ozgurselenozge/EE463-Hardware-Project/README.md

# EE463-Hardware-Project
EE463 Hardware Project: AC-DC converter
