ozgurselenozge/EE463-Hardware-Project/Term Project/463 Project Presentation.pptx

## SoC

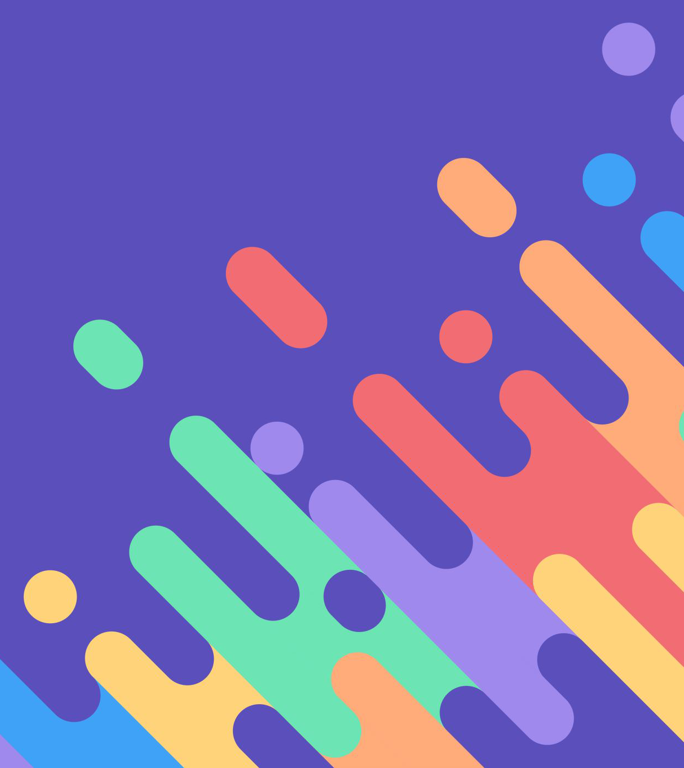
[picture p17: figure]
Vector background of vibrant colours splashing

Selen Özge Özgür
Canberk Kaçan
Onat Şimşek

## Slide 2

Design Topology

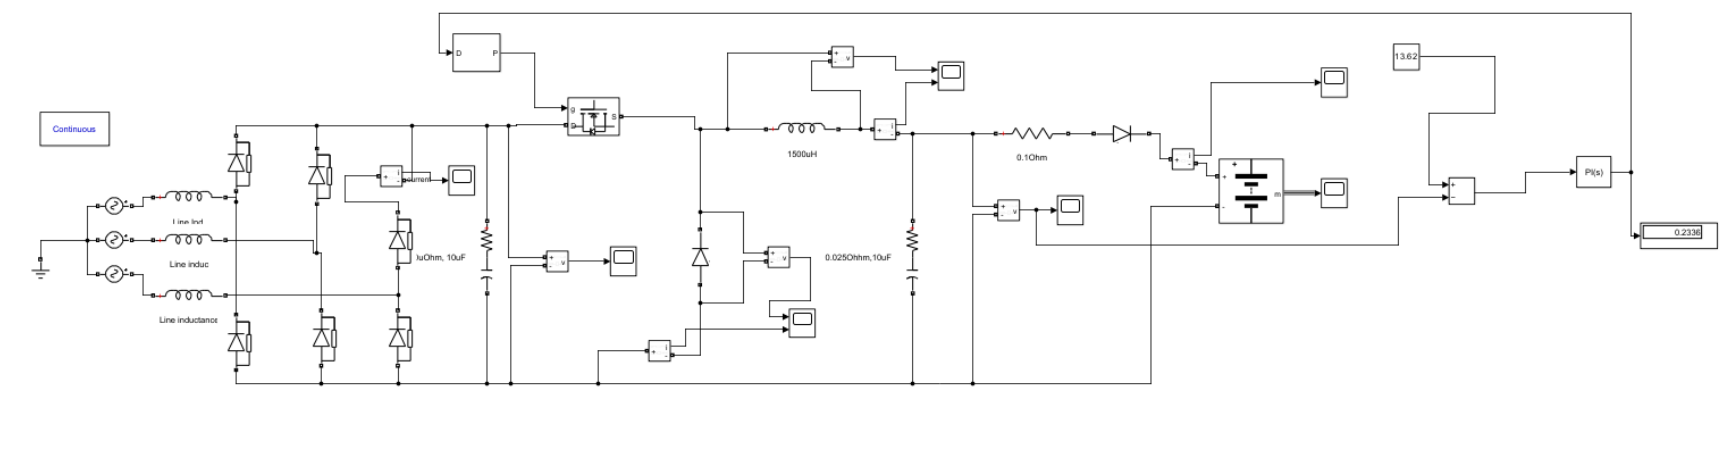
[picture p18: figure]

## Theoretical Calculations

| Theoretical Calculation | Simulation Results
Buck Converter Inductance (L) | 80. 64 µH (min) | 1500 µH
Buck Converter Capacitance | 0.83 µF | 10 µF
Three Phase FBDR Capacitance | 8.95 µF | 10 µF

## Three Phase FBDR Simulation Results

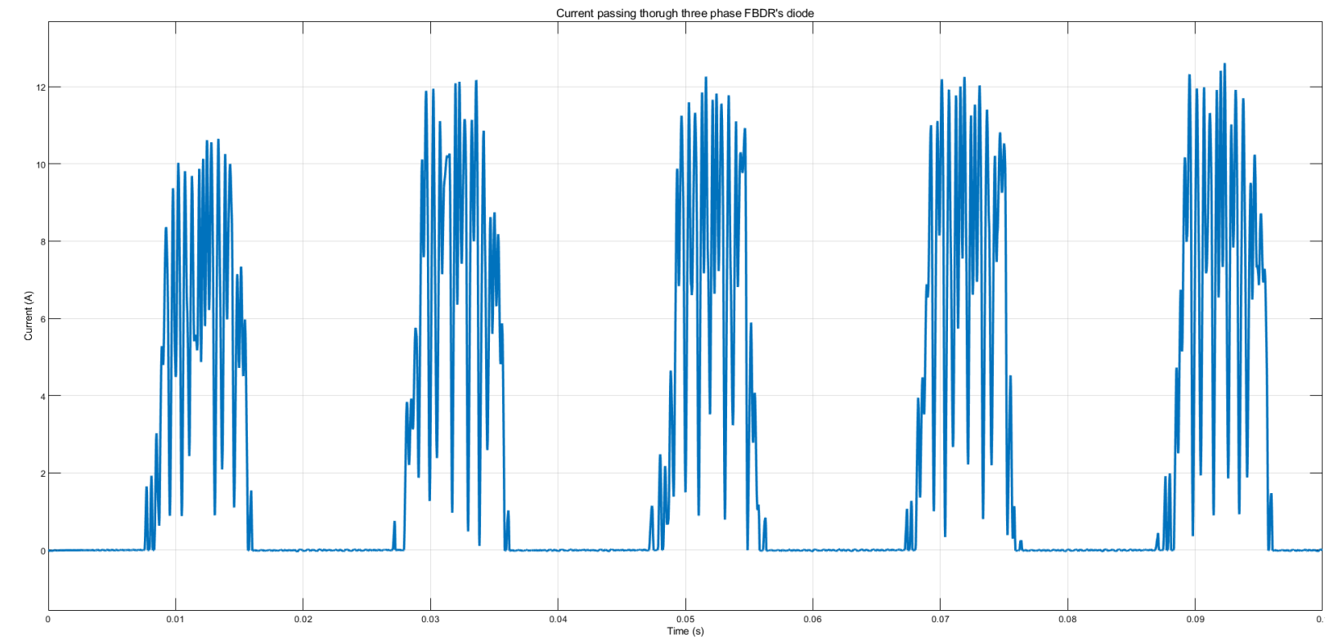
[picture p19: figure]
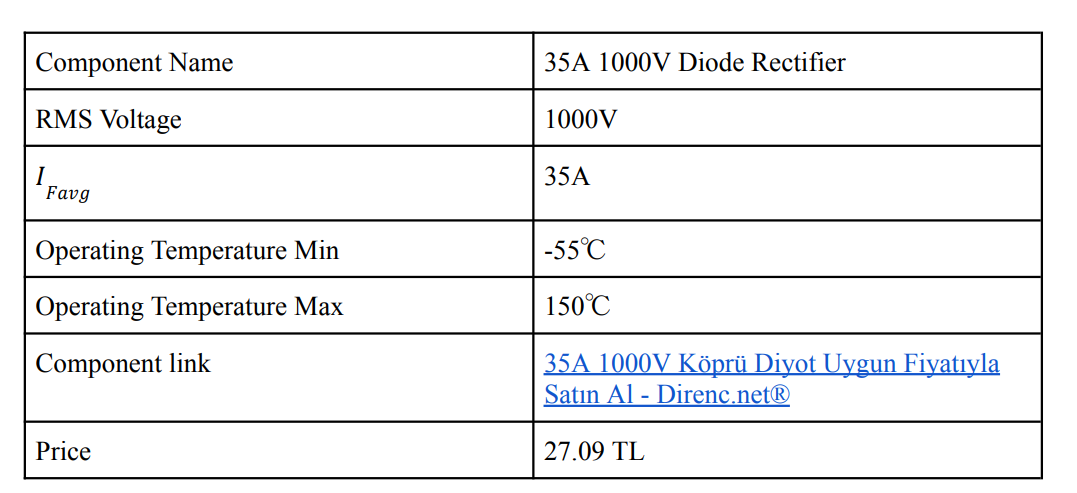
[picture p20: figure]

35A 1000V (https://www.direnc.net/35a-1000v-kopru-diyot)Köprü (https://www.direnc.net/35a-1000v-kopru-diyot) (https://www.direnc.net/35a-1000v-kopru-diyot)Diyot (https://www.direnc.net/35a-1000v-kopru-diyot) Uygun (https://www.direnc.net/35a-1000v-kopru-diyot)Fiyatıyla (https://www.direnc.net/35a-1000v-kopru-diyot) (https://www.direnc.net/35a-1000v-kopru-diyot)Satın (https://www.direnc.net/35a-1000v-kopru-diyot) Al - Direnc.net® (https://www.direnc.net/35a-1000v-kopru-diyot)

Current wavefroms of the three phase FBDR. Maximum current of the rectifier is 12 A.

## Three Phase FBDR Simulation Results

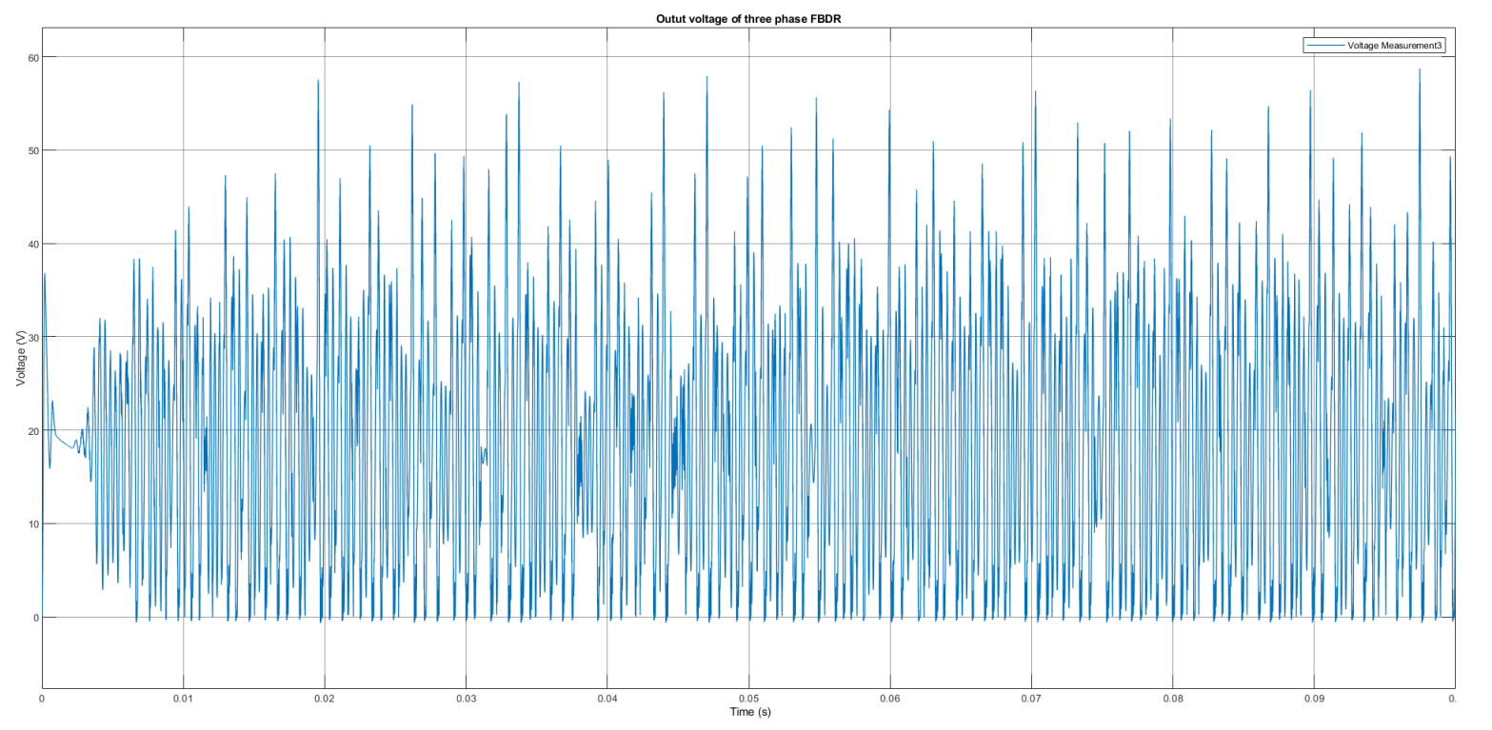
[picture p21: figure]

Output Voltage wavefroms of the three phase FBDR given. Maximum voltage seen by Three phase FBDR is 60V.

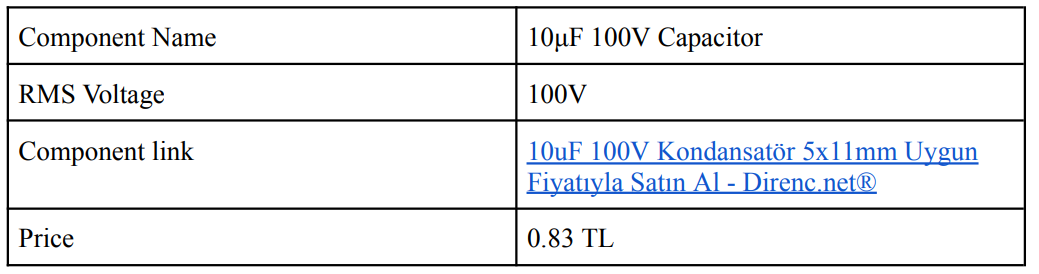
[picture p22: figure]

## Buck Converter Mosfet Waveforms

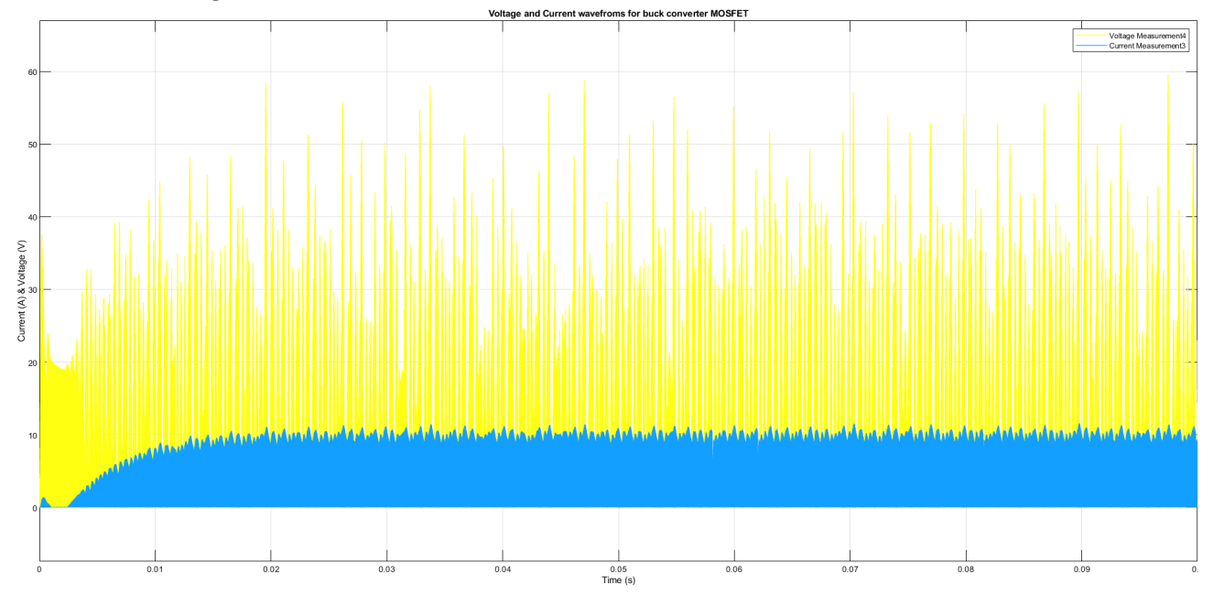
[picture p23: figure]
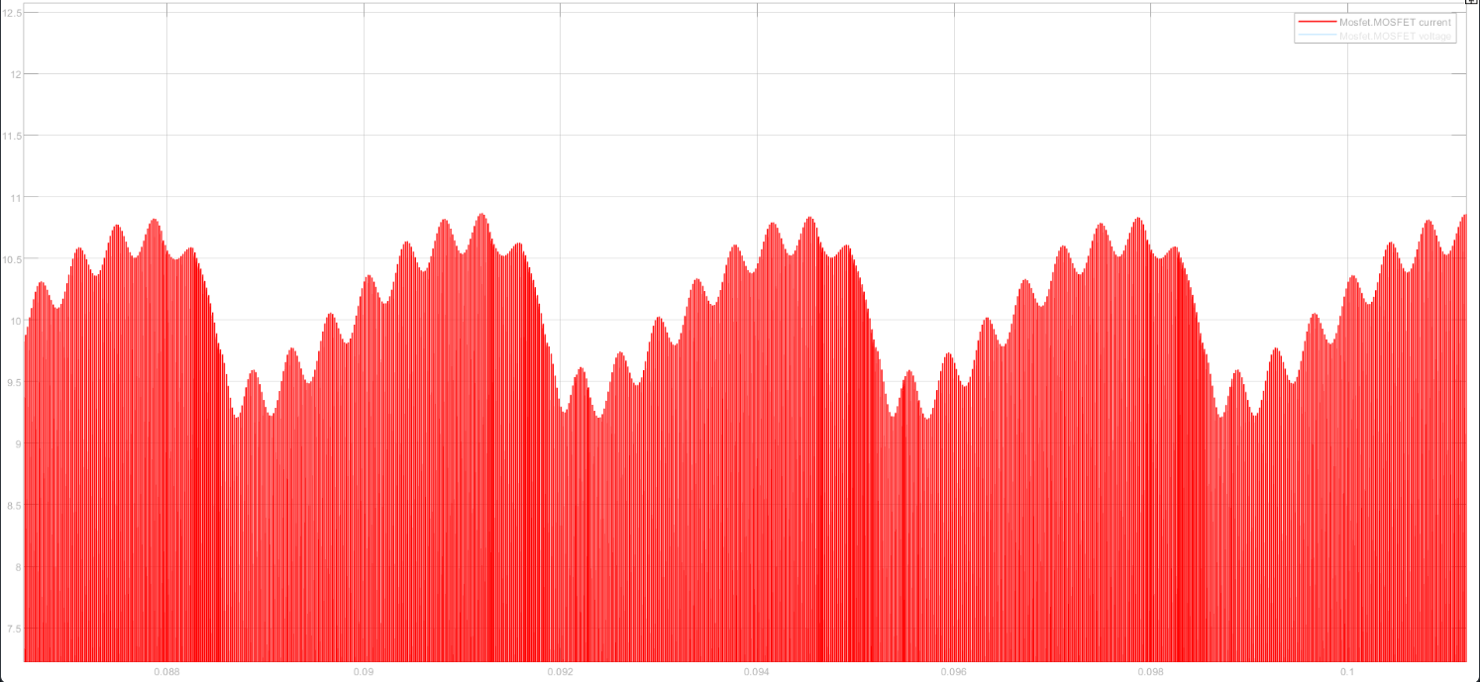
[picture p24: figure]

## Buck Converter Mosfet Waveforms

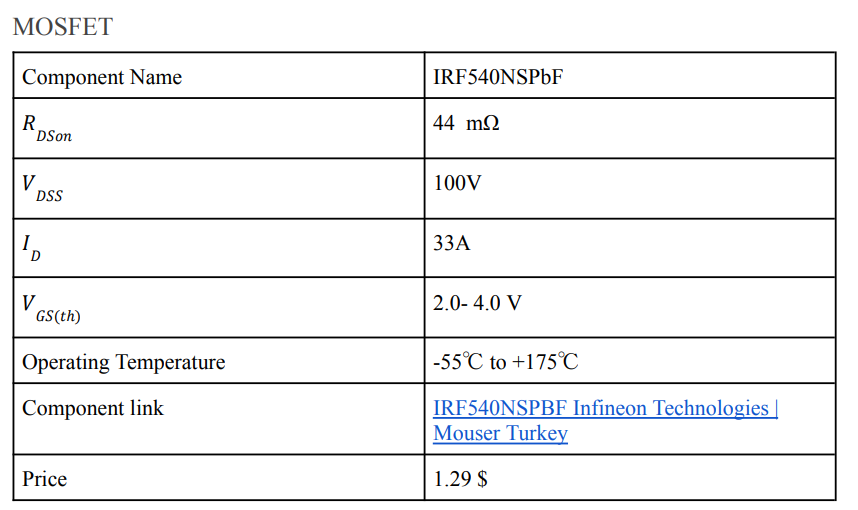
[picture p25: figure]

Buck Converter MOSFET peak current 11A, peak voltage less than 60V.

## Slide 8

Diode Waveform

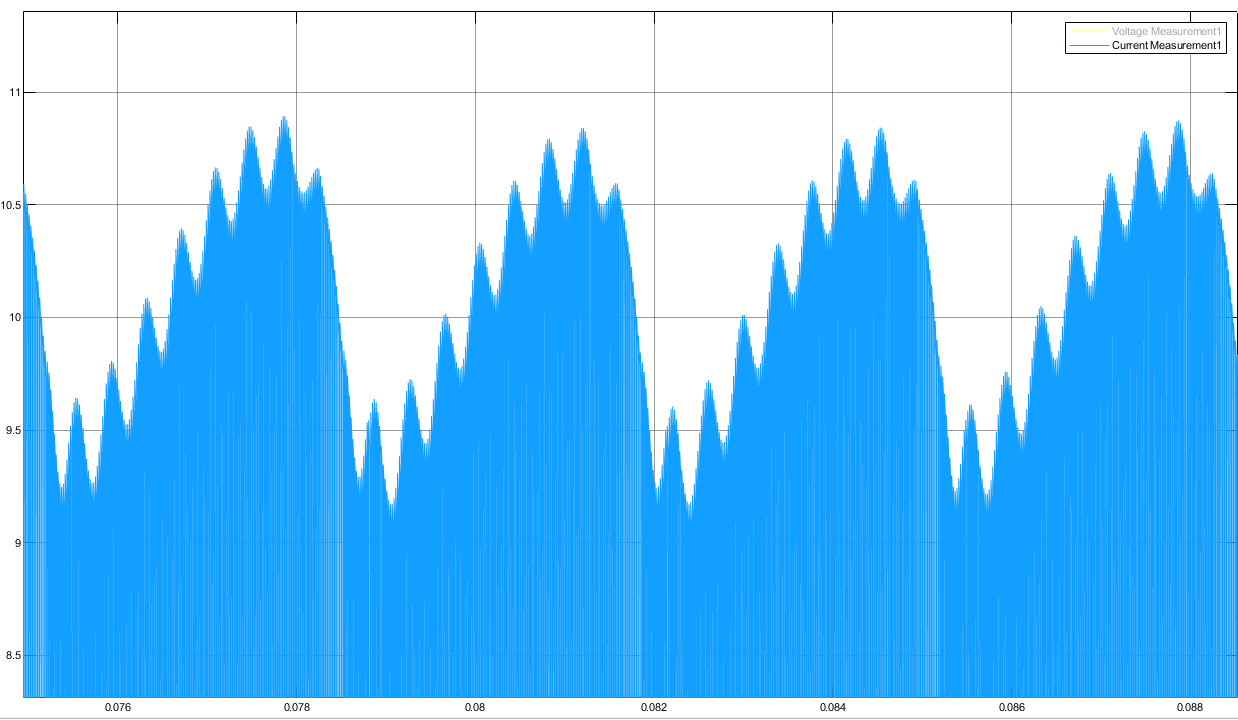
[picture p26: figure]

Peak = 11A

## Component Selection

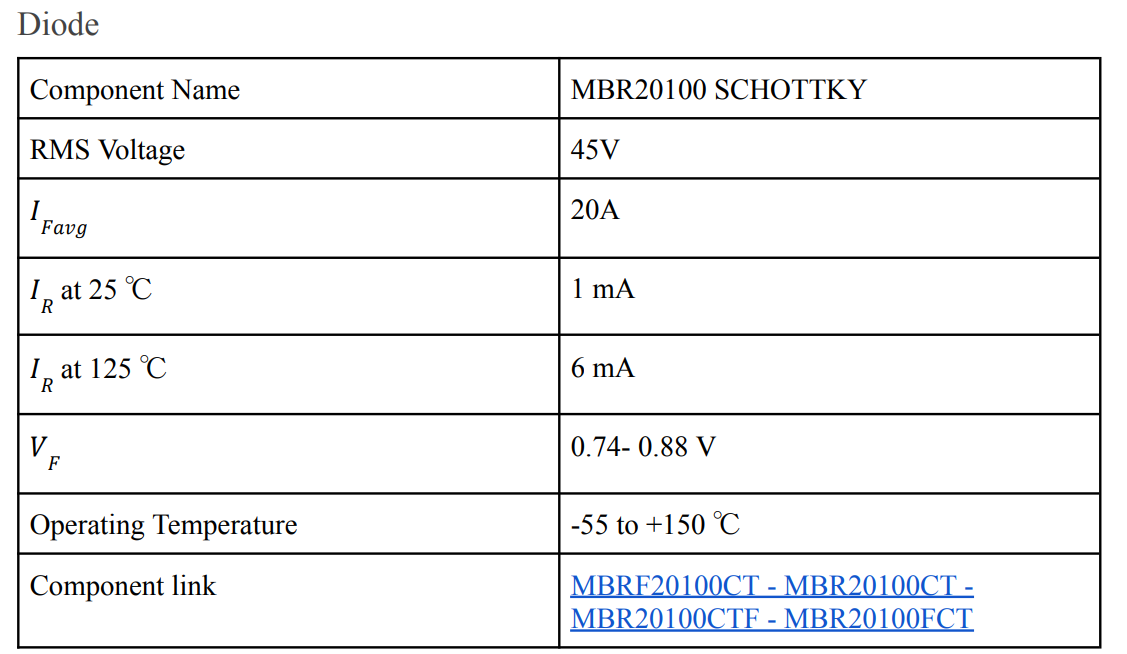
[picture p27: figure]

- Buck Converter diode peak current 11A, peak voltage less than 63.6V.

https://www.cakirelektronik.com/urun/mbr20100fct-mbr20100-20a-100v-schottky-barrier-rectifier

## Inductor Waveforms

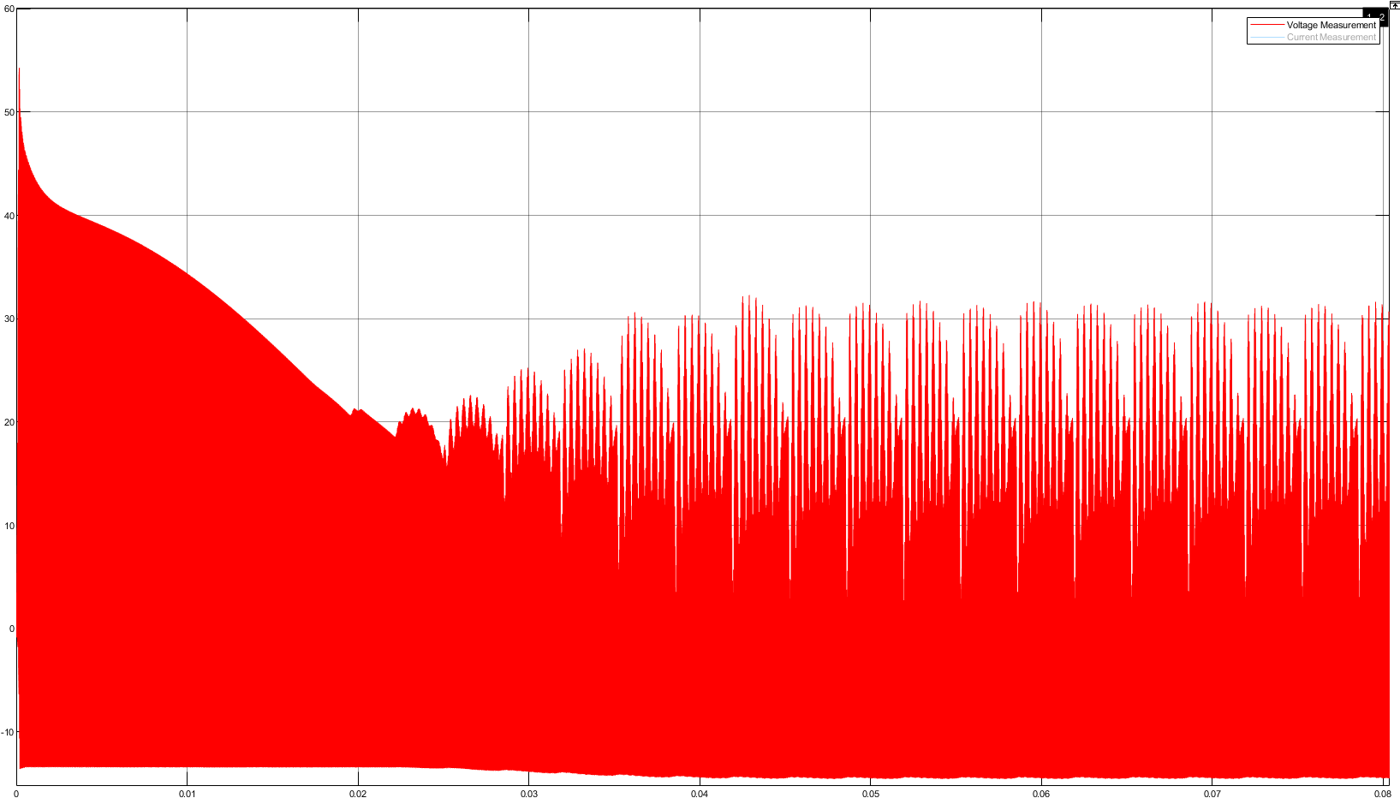
[picture p28: figure]
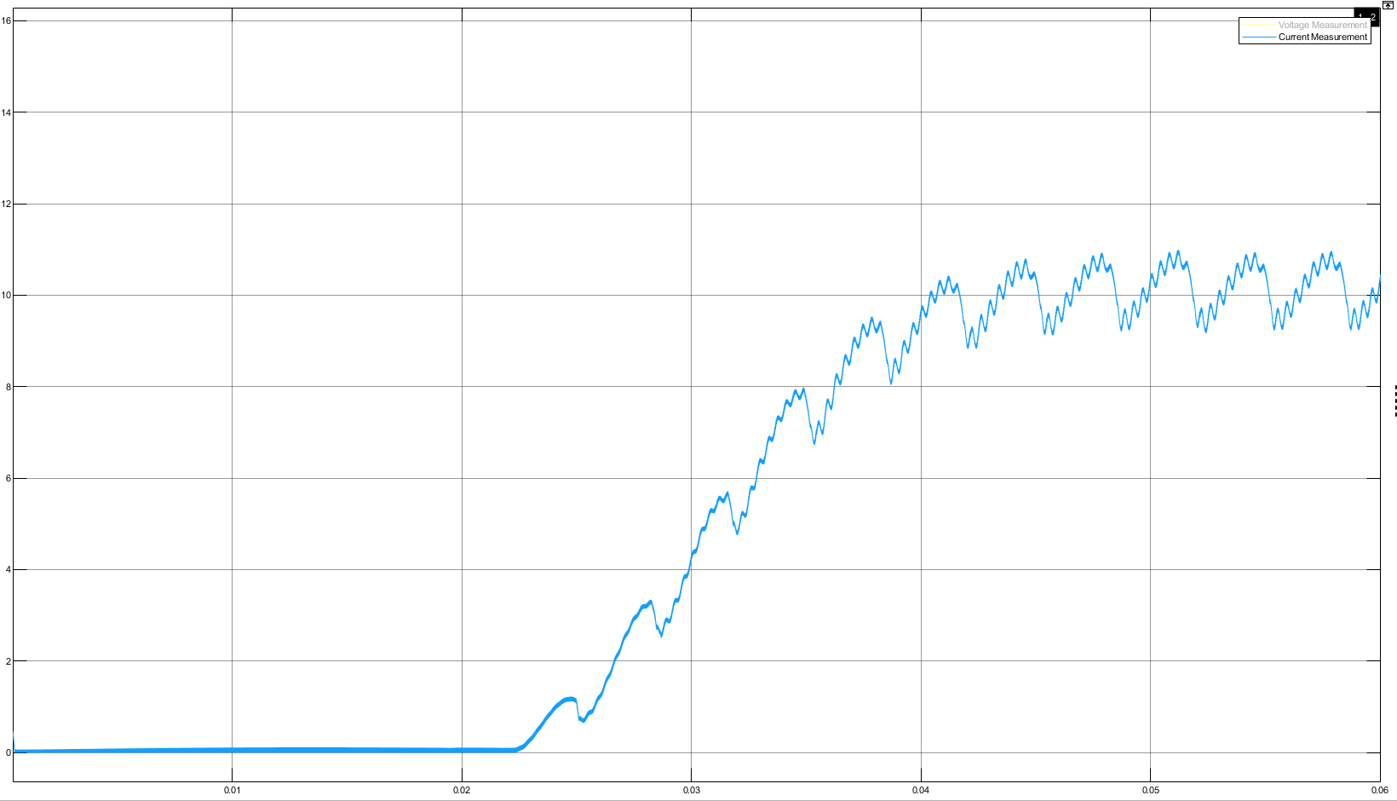
[picture p29: figure]

## Output Capacitor Waveform

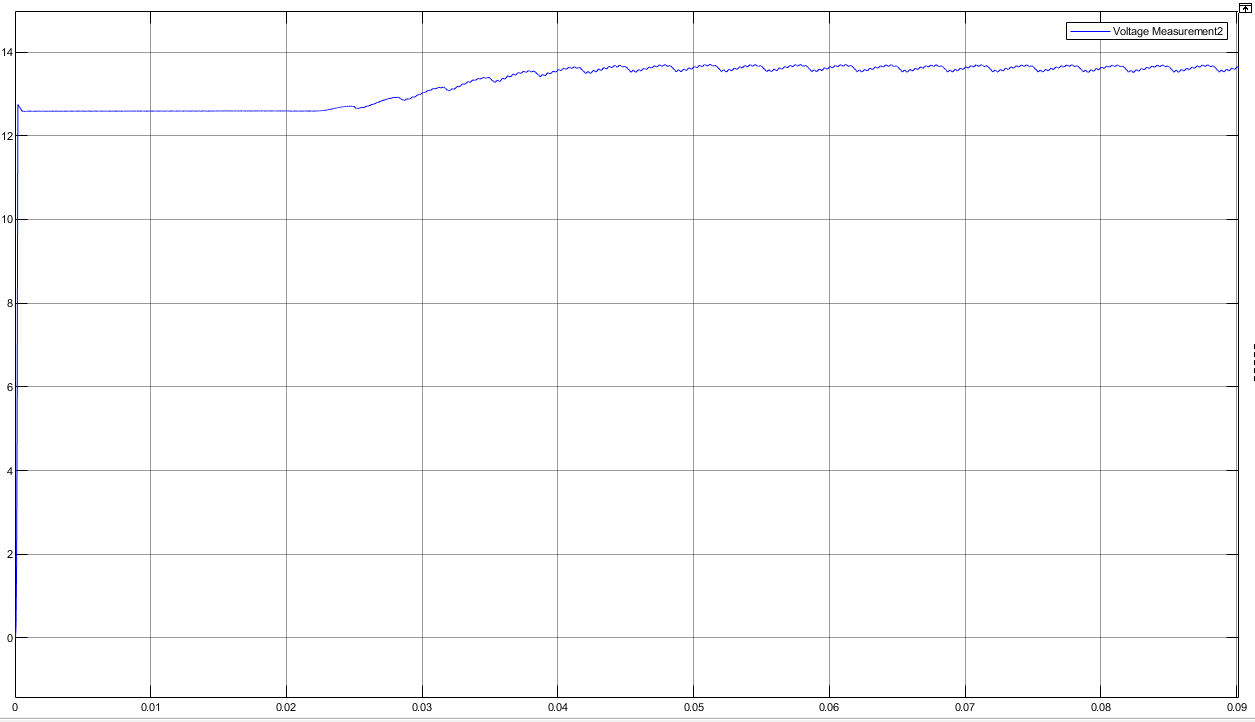
[picture p30: figure]

## Component Selection

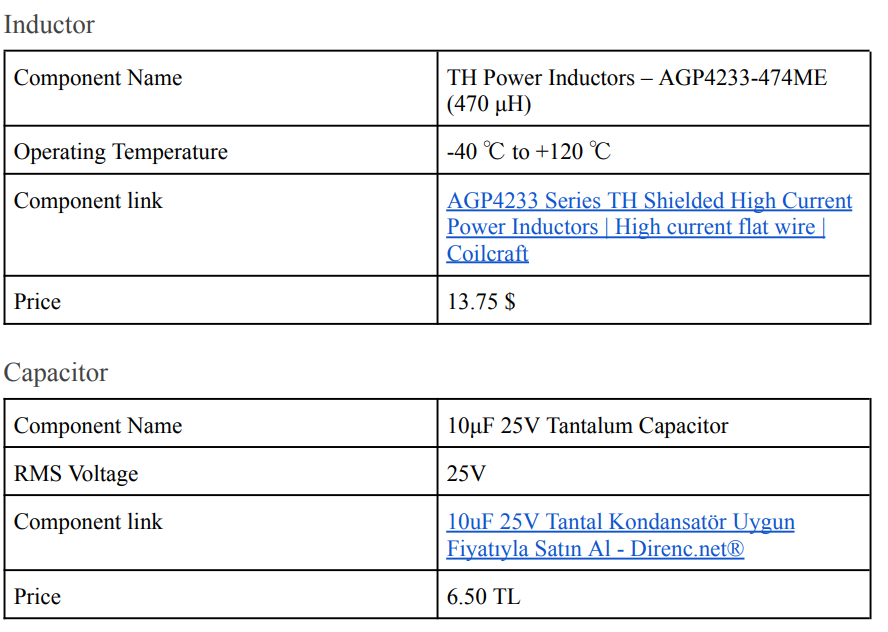
[picture p31: figure]

Buck Converter inductor peak current 11A, peak voltage less than 55V.

https://www.coilcraft.com/en-us/products/power/shielded-inductors/high-current-flat-wire/agp-ver/agp4233/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,low%20DC%20and%20AC%20resistance.

https://www.direnc.net/10uf25v-tantal

Buck Converter output capacitor peak voltage less than 13.7V.

## Slide 13

Component Selection

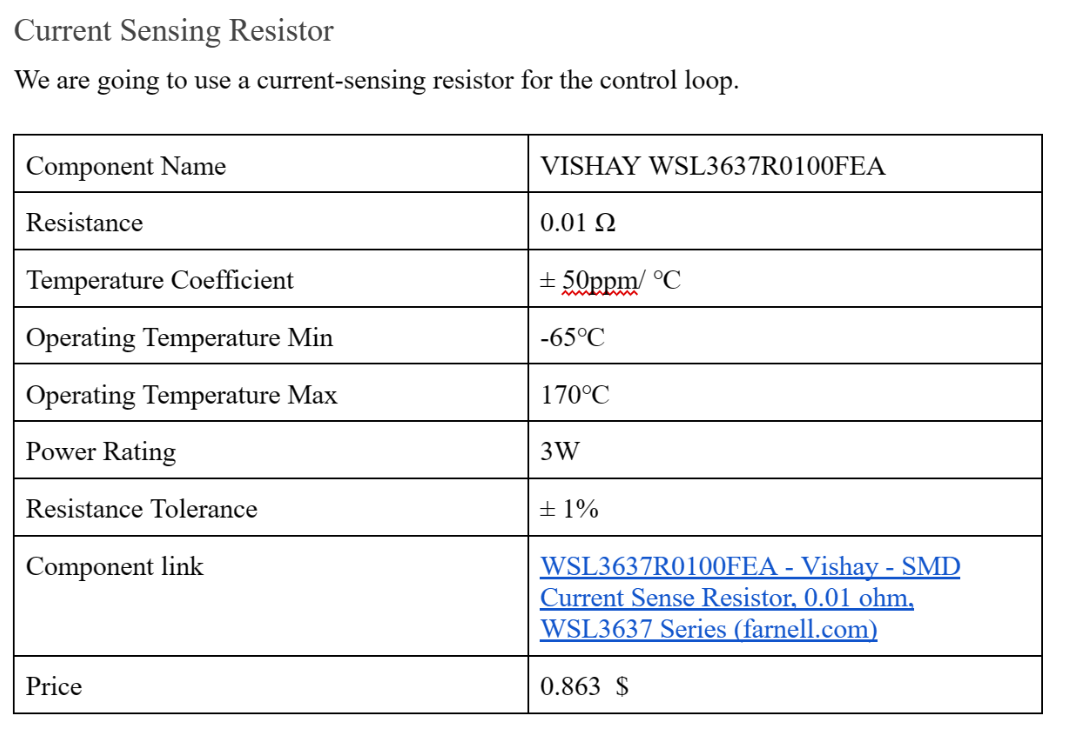
[picture p32: figure]

https://tr.farnell.com/vishay/wsl3637r0100fea/current-sense-res-0r01-1-3-w-3637/dp/2395994

## Diode, before the battery

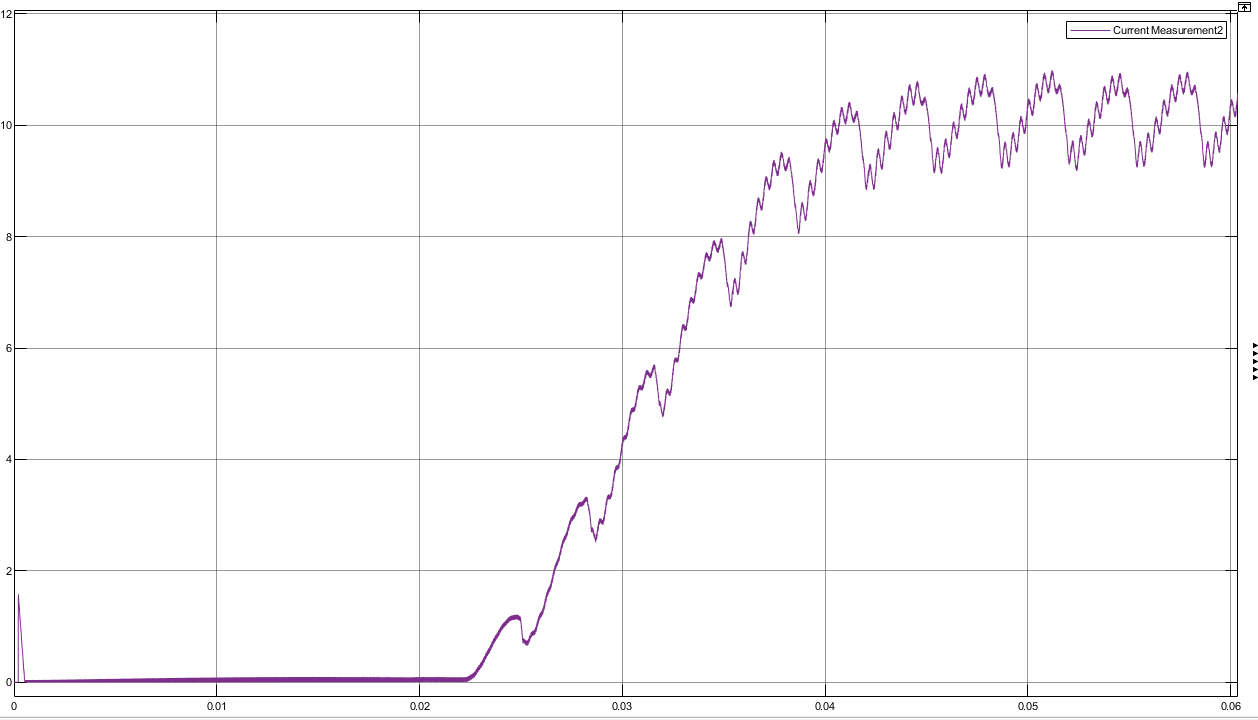
[picture p33: figure]

## Component Selection

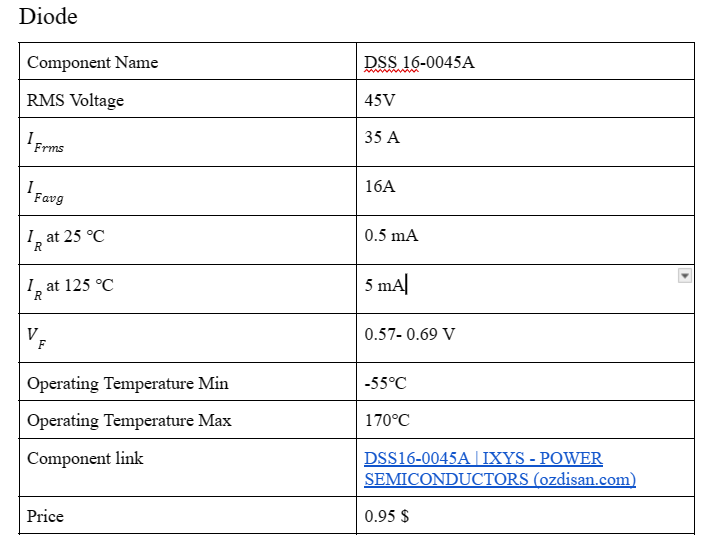
[picture p34: figure]

Buck Converter diode, before the battery, peak current 11A.

https://ozdisan.com/guc-yari-iletkenleri/diyotlar-modul-diyotlar-ve-dogrultucular/schottky-diyotlar/DSS16-0045A

## Controller Selection

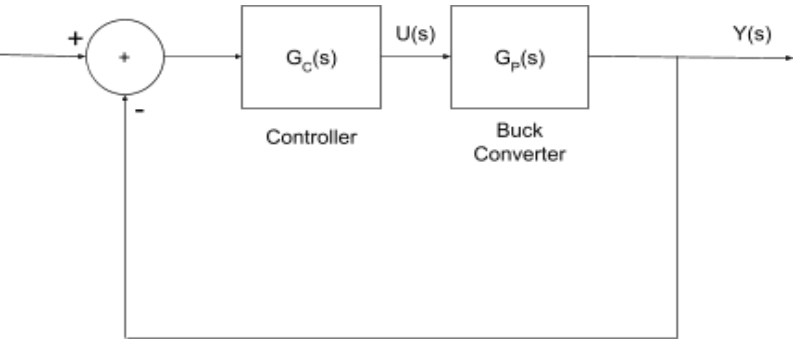
[picture p35: figure]
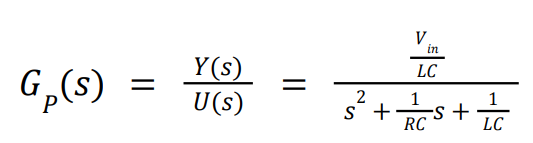
[picture p36: figure]

Transfer Function of the Buck converter is given above.
Y(s): Voltage output of the buck converter
U(s): Duty cycle

## Controller Selection

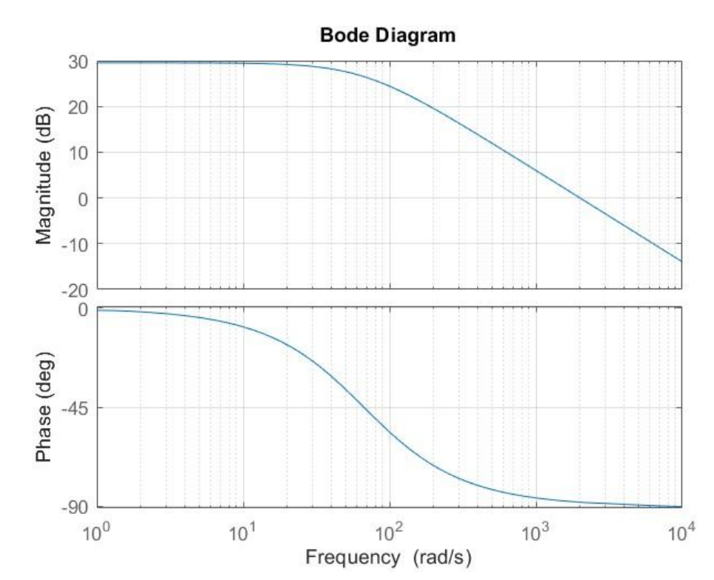
[picture p37: figure]

Bode Diagram of the open loop buck converter

By using PID tunning:
Kp = 0.068125711694835
Ki = 6.811891811116887

## Will be added

- Fuse (15A) after FBDR (before MOSFET) for currrent protection
- Analog or Digital Controller
- Over voltage protection (if we have time)
