ozgurselenozge/EE463-Hardware-Project/Term Project/3_phase_PWM_rectifier.pdf

# Three Phase Rectifier

## Vieri Xue

## C2000 System Application Engineer

# Content

## - Hardware Design Review

## - Software Design Review

## - Close-Loop Controller Review

# Introduction

## - Rectifier functions:

1. The AC to DC conversion.
2. Improve the power factor.
3. Reduce the THDi.

# Introduction

## - Three Phase PFC Topology - 6 Pulse + SCR + LC

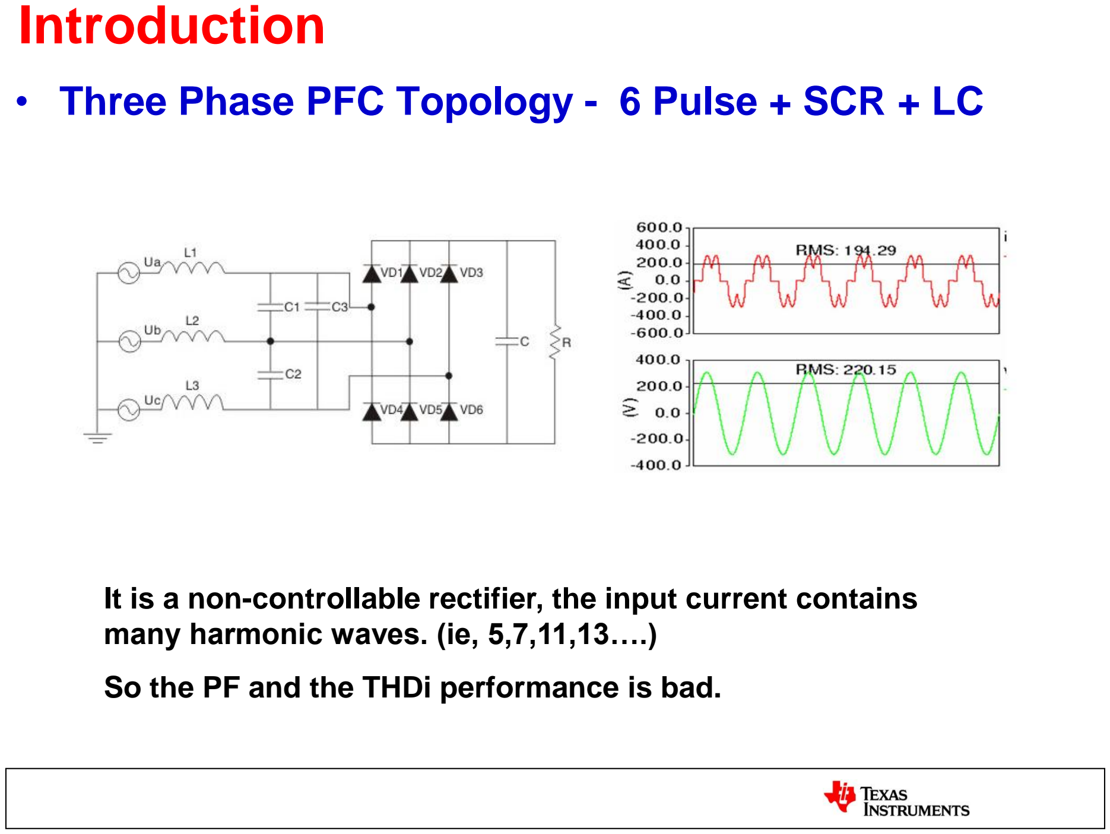
[picture p82: page 4]

It is a non-controllable rectifier, the input current contains many harmonic waves. (ie, 5,7,11,13….)

So the PF and the THDi performance is bad.

# Introduction

## - Three Phase PFC Topology - 12pulse + SCR + L

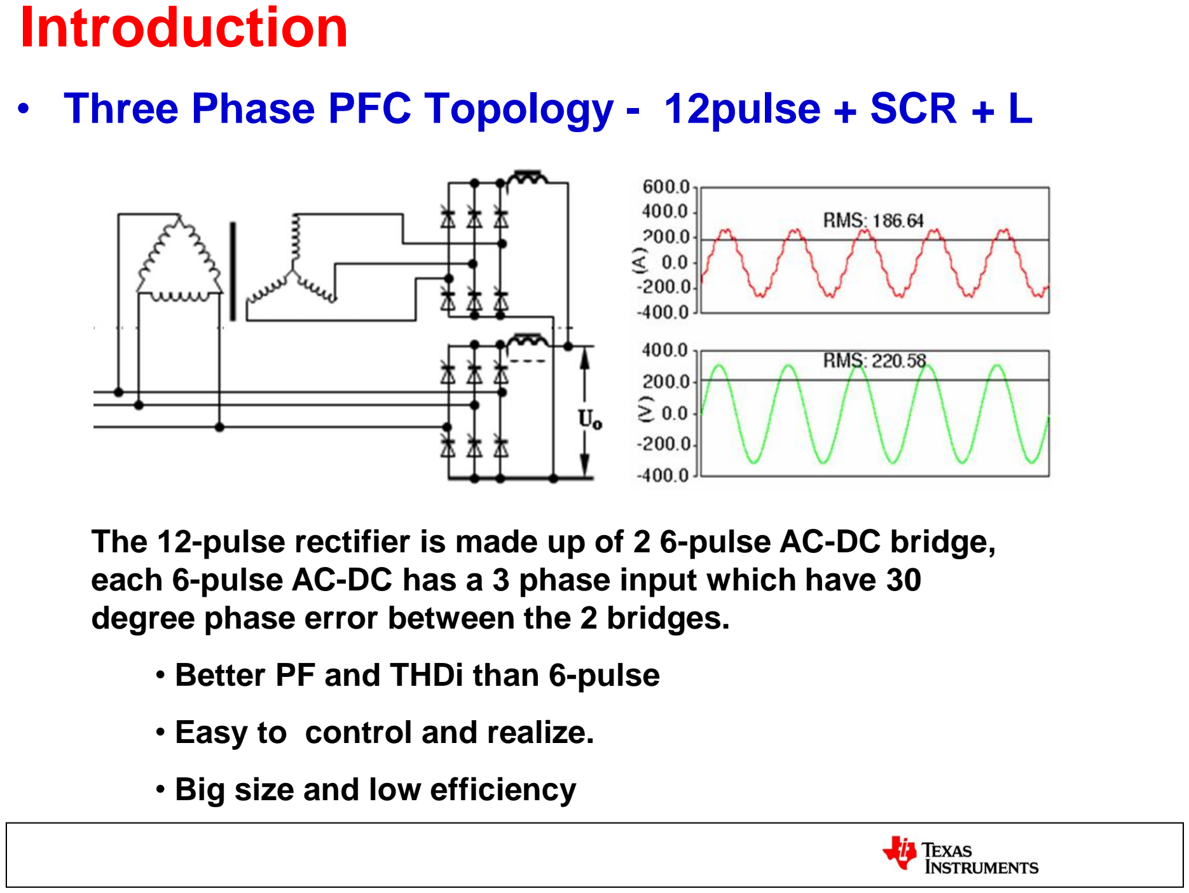
[picture p83: page 5]

The 12-pulse rectifier is made up of 2 6-pulse AC-DC bridge, each 6-pulse AC-DC has a 3 phase input which have 30 degree phase error between the 2 bridges.

- Better PF and THDi than 6-pulse
- Easy to control and realize.
- Big size and low efficiency

# Introduction

## - Three Phase PFC Topology - Vienna topology

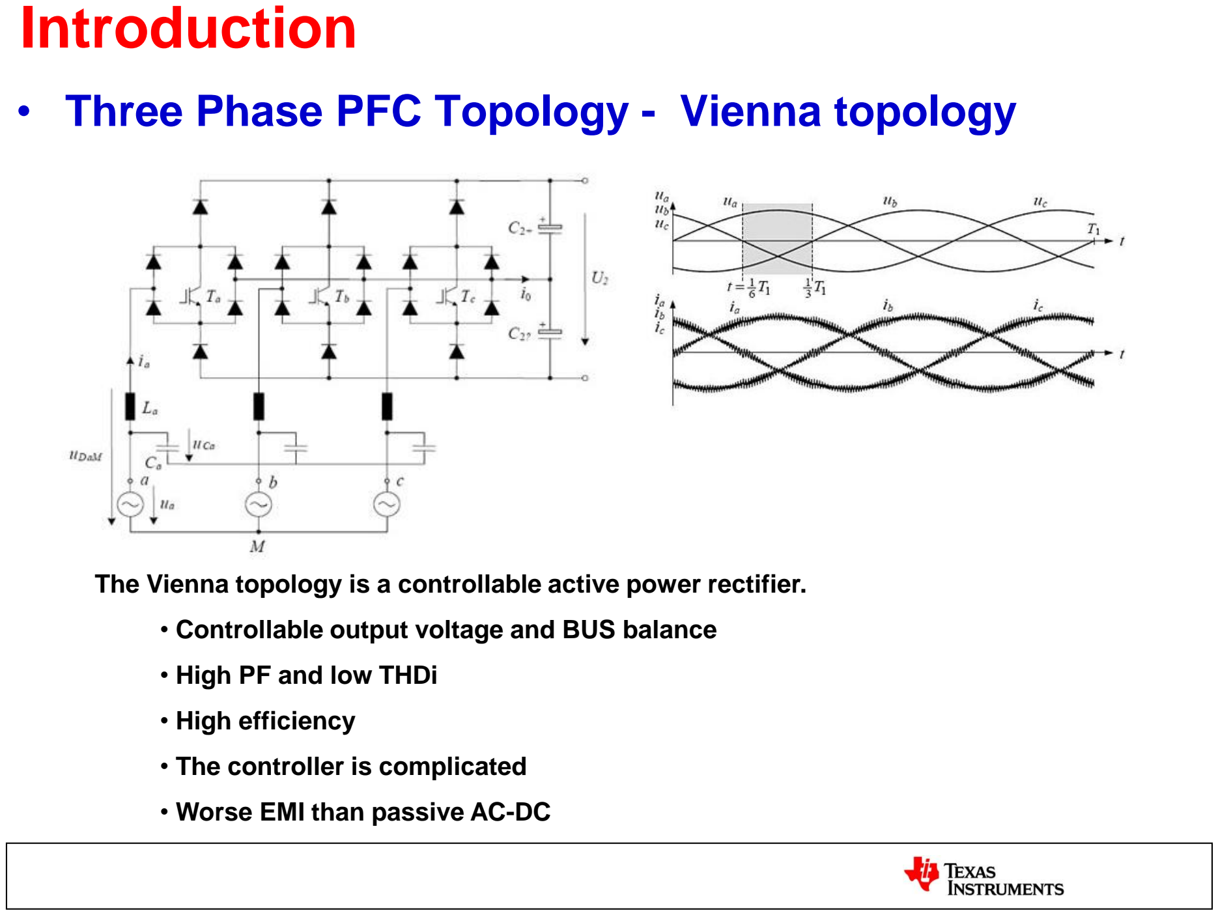
[picture p84: page 6]

The Vienna topology is a controllable active power rectifier.

- Controllable output voltage and BUS balance
- High PF and low THDi
- High efficiency
- The controller is complicated
- Worse EMI than passive AC-DC

# Introduction

## - Three Phase PFC Topology - 3 phase 2-level PWM

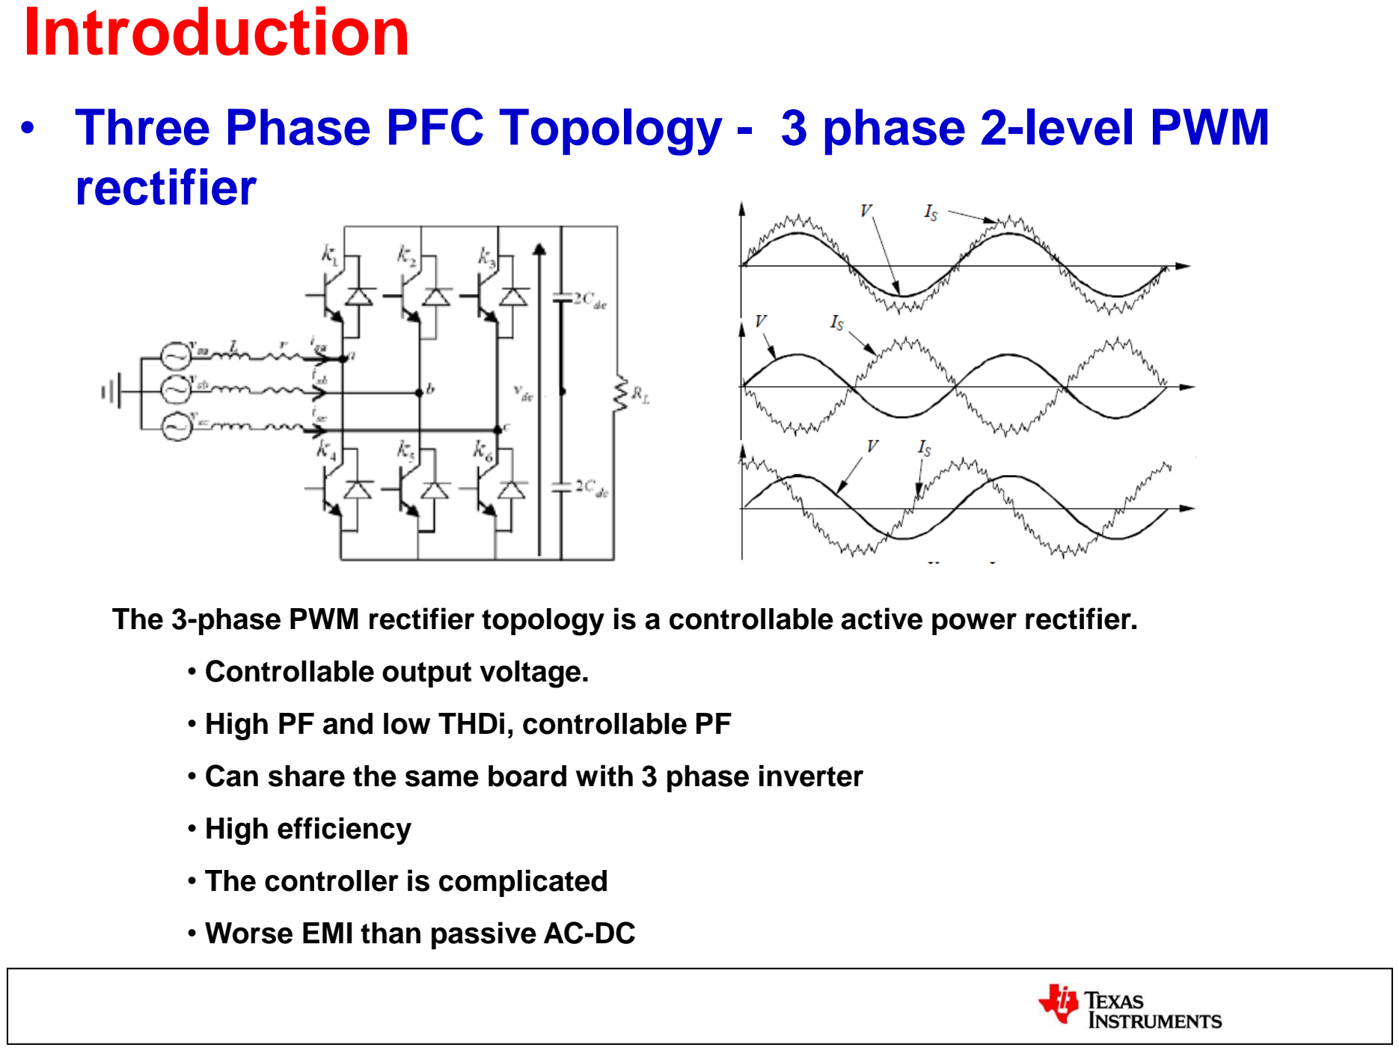
[picture p85: page 7]

## rectifier

The 3-phase PWM rectifier topology is a controllable active power rectifier.

- Controllable output voltage.
- High PF and low THDi, controllable PF
- Can share the same board with 3 phase inverter
- High efficiency
- The controller is complicated
- Worse EMI than passive AC-DC

# Introduction

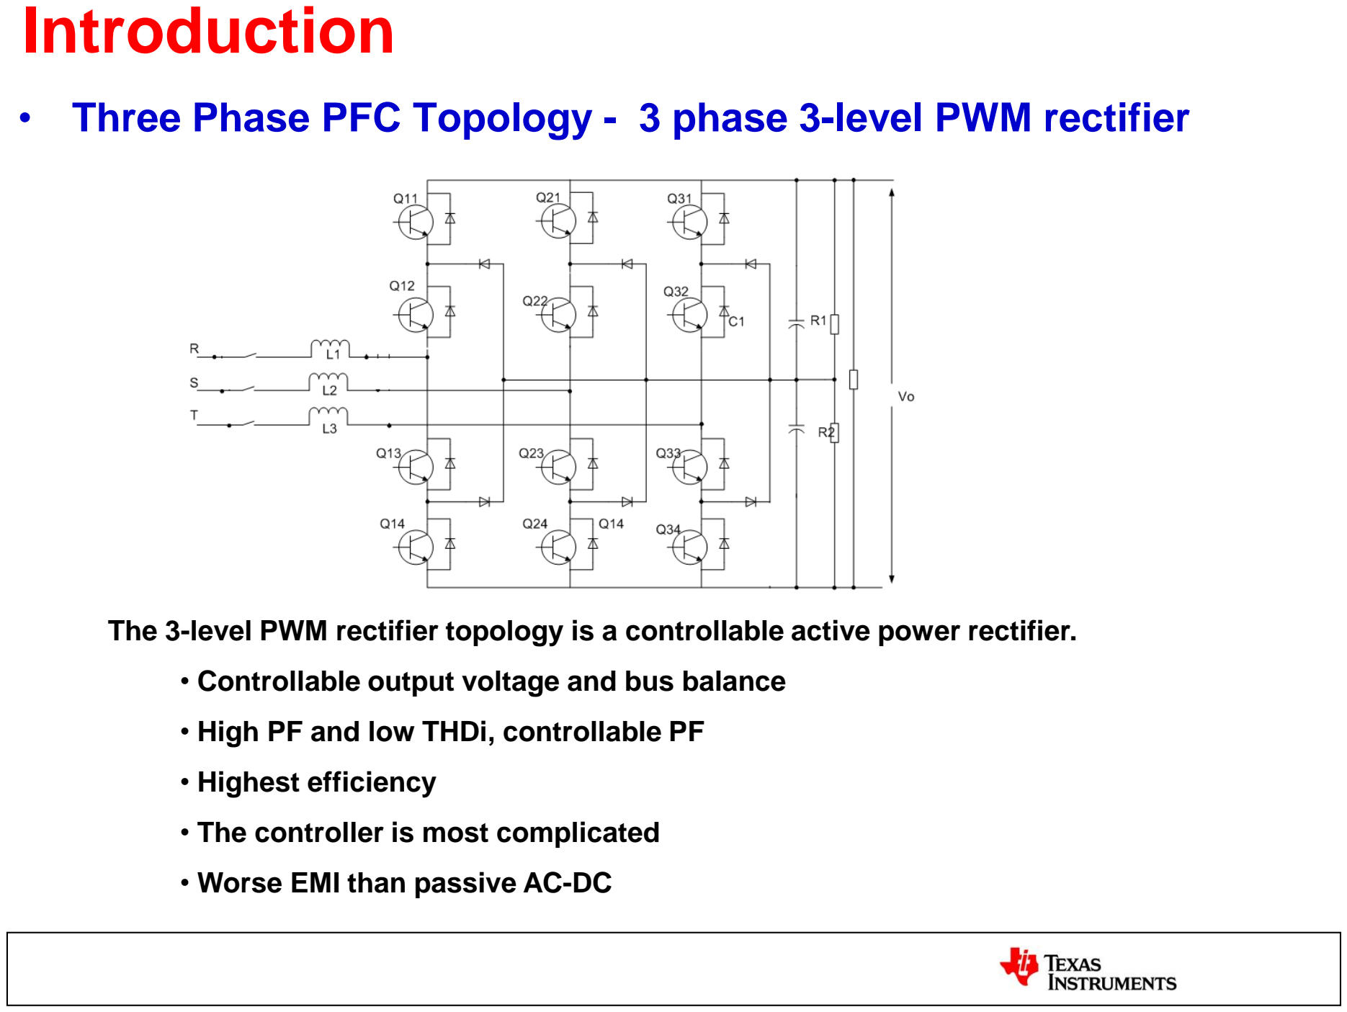
[picture p86: page 8]

- Three Phase PFC Topology - 3 phase 3-level PWM rectifier

The 3-level PWM rectifier topology is a controllable active power rectifier.

- Controllable output voltage and bus balance
- High PF and low THDi, controllable PF
- Highest efficiency
- The controller is most complicated
- Worse EMI than passive AC-DC

# Introduction

## - Application field

– | UPS
– | Telecommunication
– | Motor driver
– | Motor Energy Feedback Unit
– | Active Power Filter

# Introduction

## - 3-Phase 2-level PWM Rectifier principle

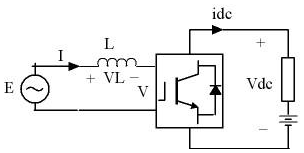
[picture p87: figure]
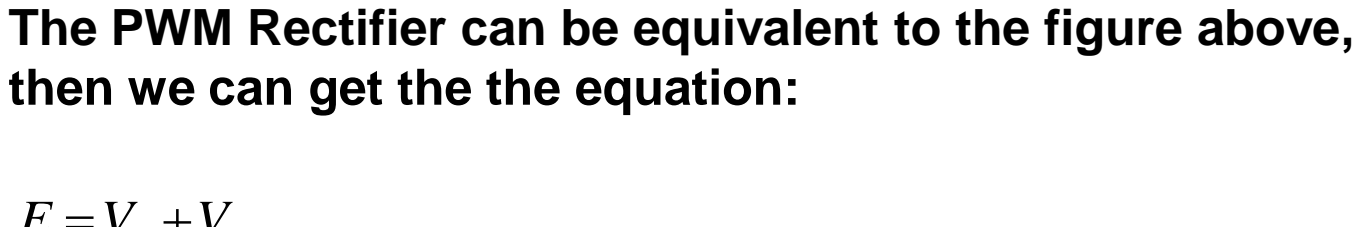
[picture p88: figure]
then we can get the the equation:

The PWM Rectifier can be equivalent to the figure above,

E V | V = | +L
ac ac | dc dc i v | i v =

# Introduction

## - Three Phase PWM Rectifier principle

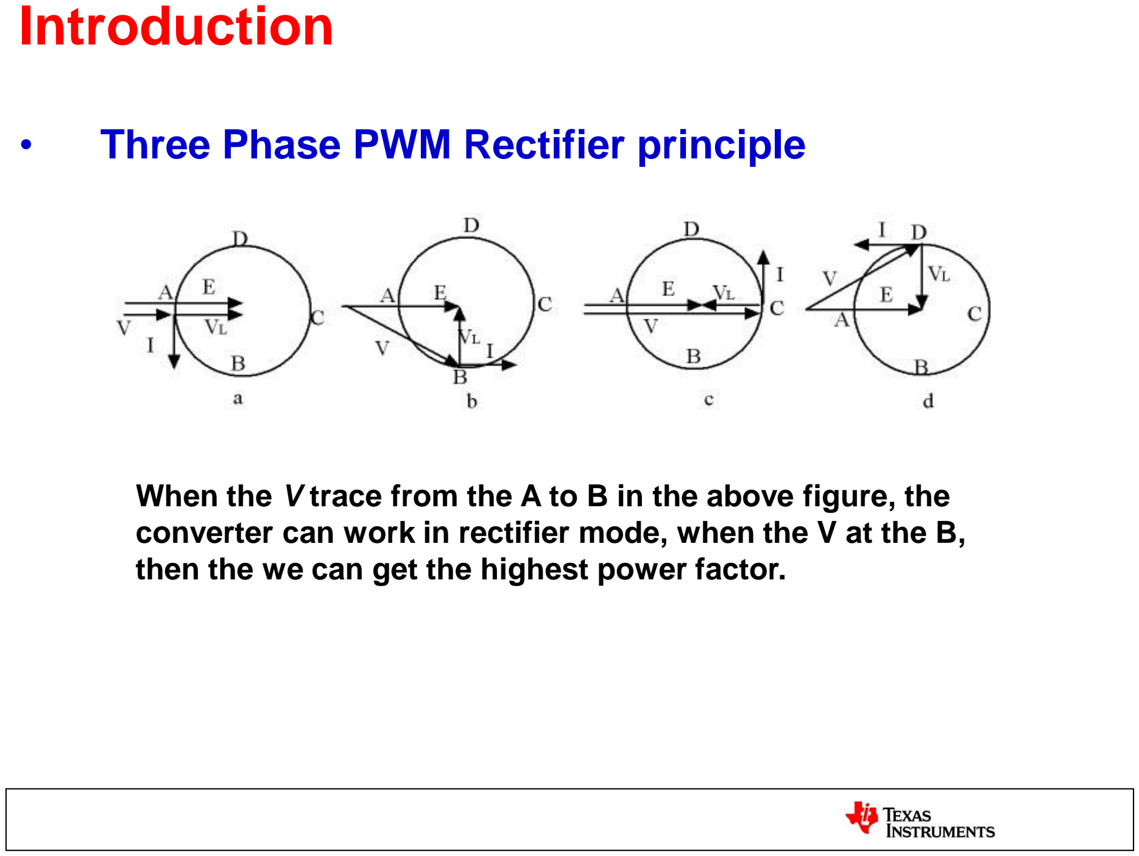
[picture p89: page 11]

When the V trace from the A to B in the above figure, the converter can work in rectifier mode, when the V at the B, then the we can get the highest power factor.

# Introduction

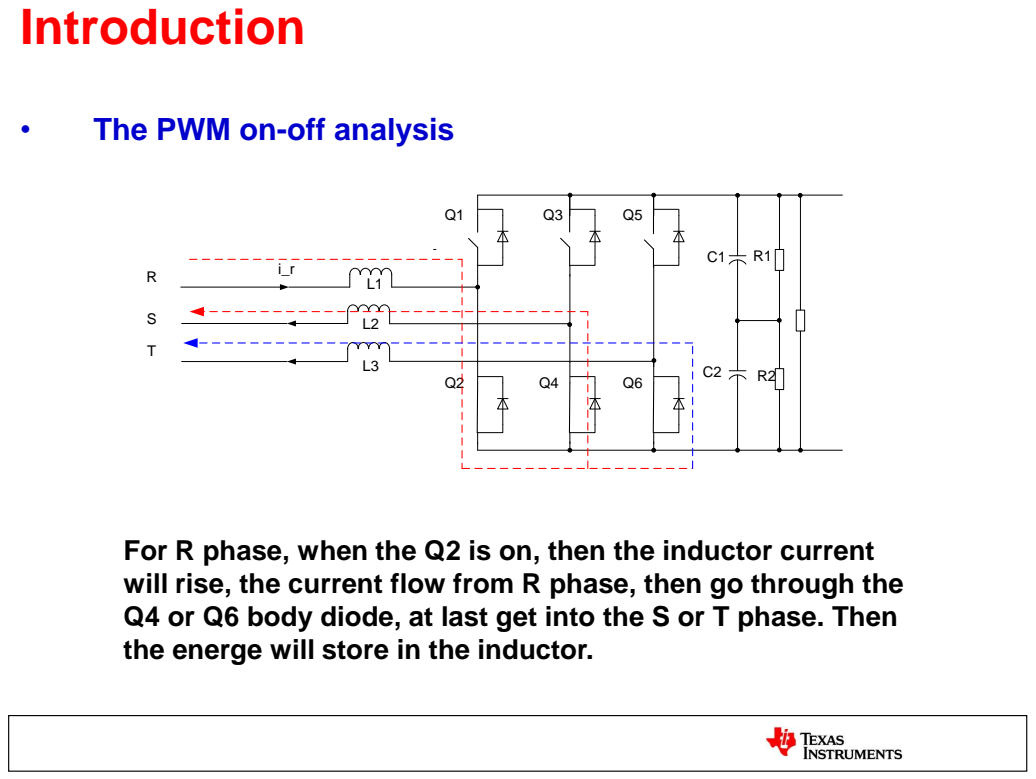
[picture p90: page 12]

• The PWM on-off analysis

For R phase, when the Q2 is on, then the inductor current
will rise, the current flow from R phase, then go through the
Q4 or Q6 body diode, at last get into the S or T phase. Then
the energe will store in the inductor.

# Introduction

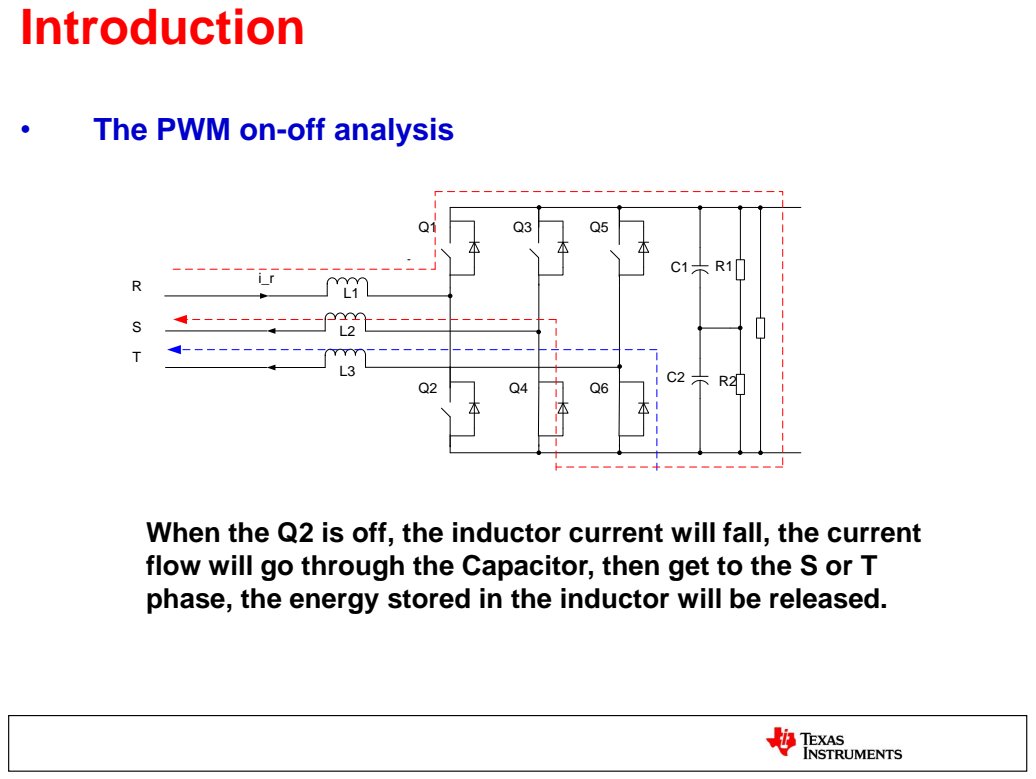
[picture p91: page 13]

• The PWM on-off analysis

When the Q2 is off, the inductor current will fall, the current
flow will go through the Capacitor, then get to the S or T
phase, the energy stored in the inductor will be released.

# Introduction

## - 3-phase PFC EVM basic specification

– | 3 phase 4 wire(or 3wire) input
– | 1200W @ 380VAC/50Hz
– | Output Voltage: 700VDC
– | Efficiency: >95%
– | THDi<5% @ Full load
– | Current unbalance ratio: <3%
– | Power Factor > 0.99 @ >50% Load
– | Piccolo B
– | GUI support

# Introduction

## - 3-phase PFC EVM Picture

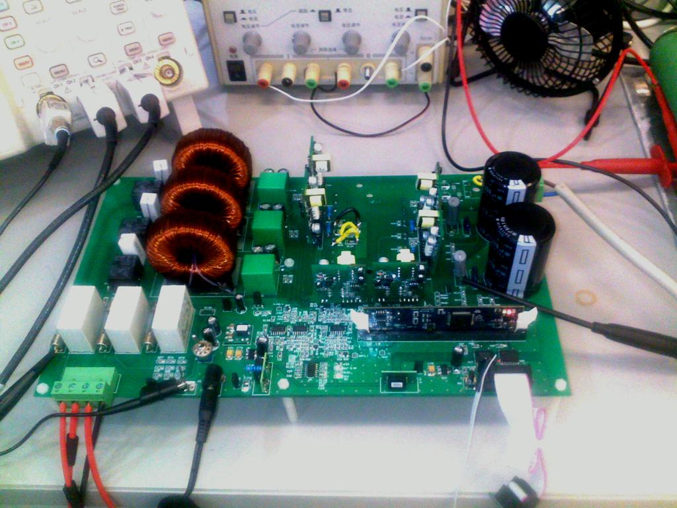
[picture p92: figure]

# Content

## - Introduction

## - Software Design Review

## - Close-Loop Controller Review

# Hardware Design Review

# - Main circuit topology

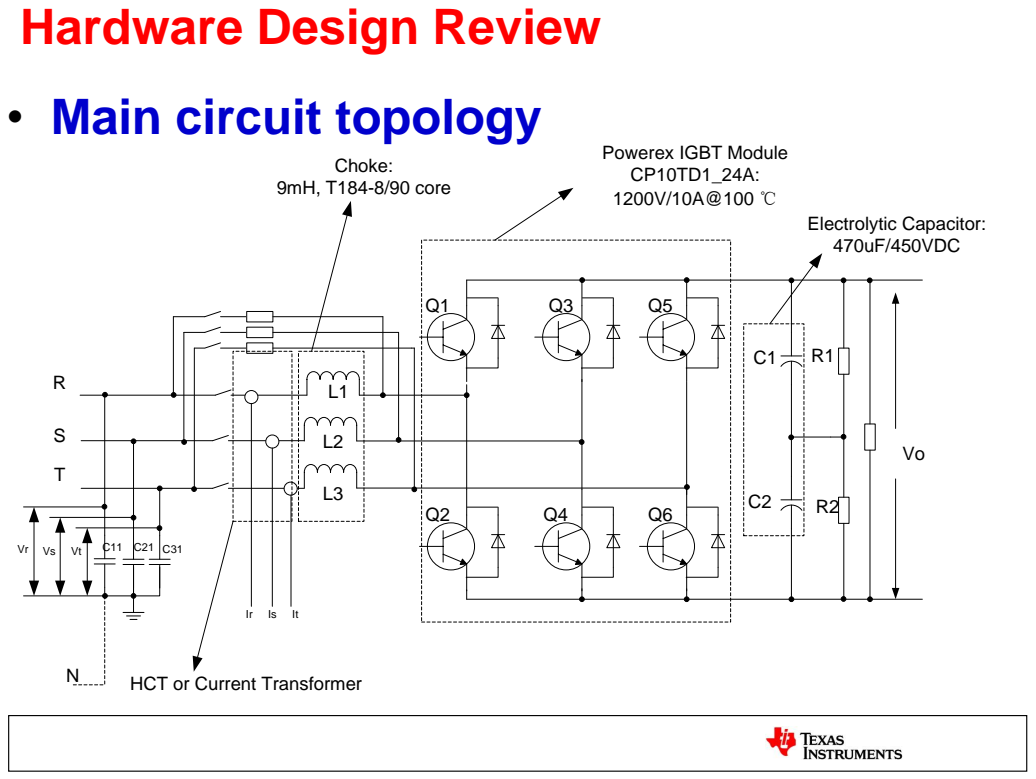
[picture p93: page 17]

HCT or Current Transformer

# Hardware Design Review

# - Main circuit considerations

### 4. Current sensing ---- HCT need to be used for current controller. 2 HCTs

at least.

1.Switch Frequency ---- 20kHz.
For motor control application, the Fs can be reduced to 10kHz, and the choke size will be bigger and the inductance is higher.

### 2. IGBT

1200V IGBT must be used in this topology, because the maximum voltage between the Vce is over 700V in theory. Actually, the 30% margin need to be considered.

### 3. Electrolytic Capacitor

The output DC voltage is larger than 600VDC in 380VAC system, then we must use 2 electrolytic capacitors in series.

### 5. Line voltage sensing --- Line- Neutral voltage(or Line to Line) need to be

sensed

# Hardware Design Review

# - The inductor design

The inductor is determined by the following parameters:
- The DC output voltage and input voltage
- The switching frequency
- The current ripple needed

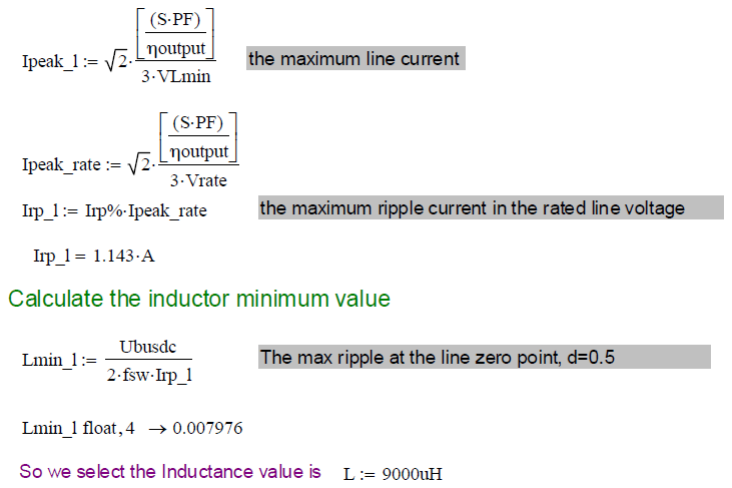
[picture p94: figure]

# Hardware Design Review - IGBT driver

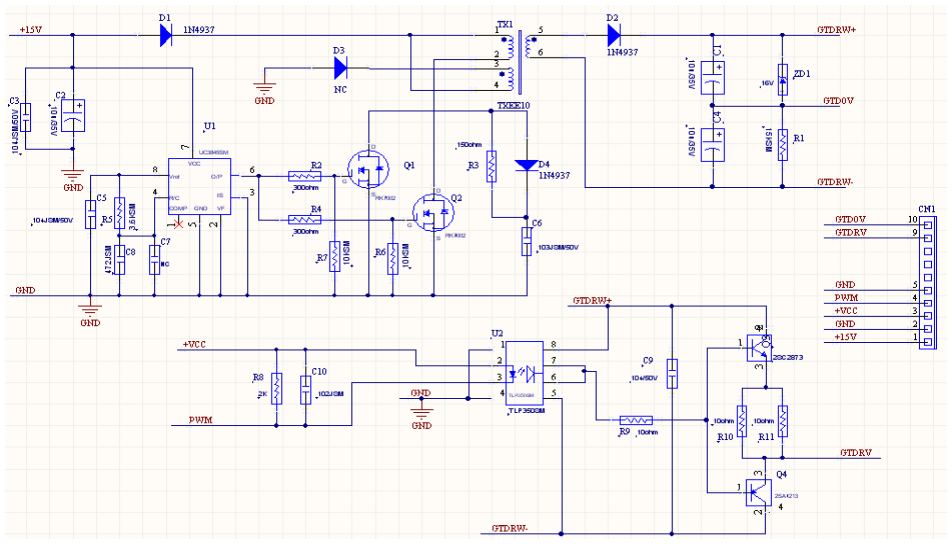
[picture p95: figure]

The single 15V power input IGBT driver is used in this project. The driver was designed for IGBT application with the maximum Fs 40kHz.

# Hardware Design Review - Auxiliary Power

The project did not design a three phase input auxiliary power for the system, all the power is from the external +15V adapter.
- The +5V is generated by the PTH08080 with the +15V input
- The +3.3V is generated by the TLV1117-33, with the +5V input
- The -15V used by the HCT, is generated by the DCH010515S with +5V input.

# Hardware Design Review - Soft start circuit

When the line voltage connect to the board, the bus capacitor will be charged by the soft start circuit, and the voltage will rise to about 300V. The soft start must be finished before the converter start to work.
In order to charge the bus in a limited current, there is a 1k/5w resistor in each phase. Besides, 3 relays are used to connect the line input to softstart circuit.

# Hardware Design Review - MCU interface

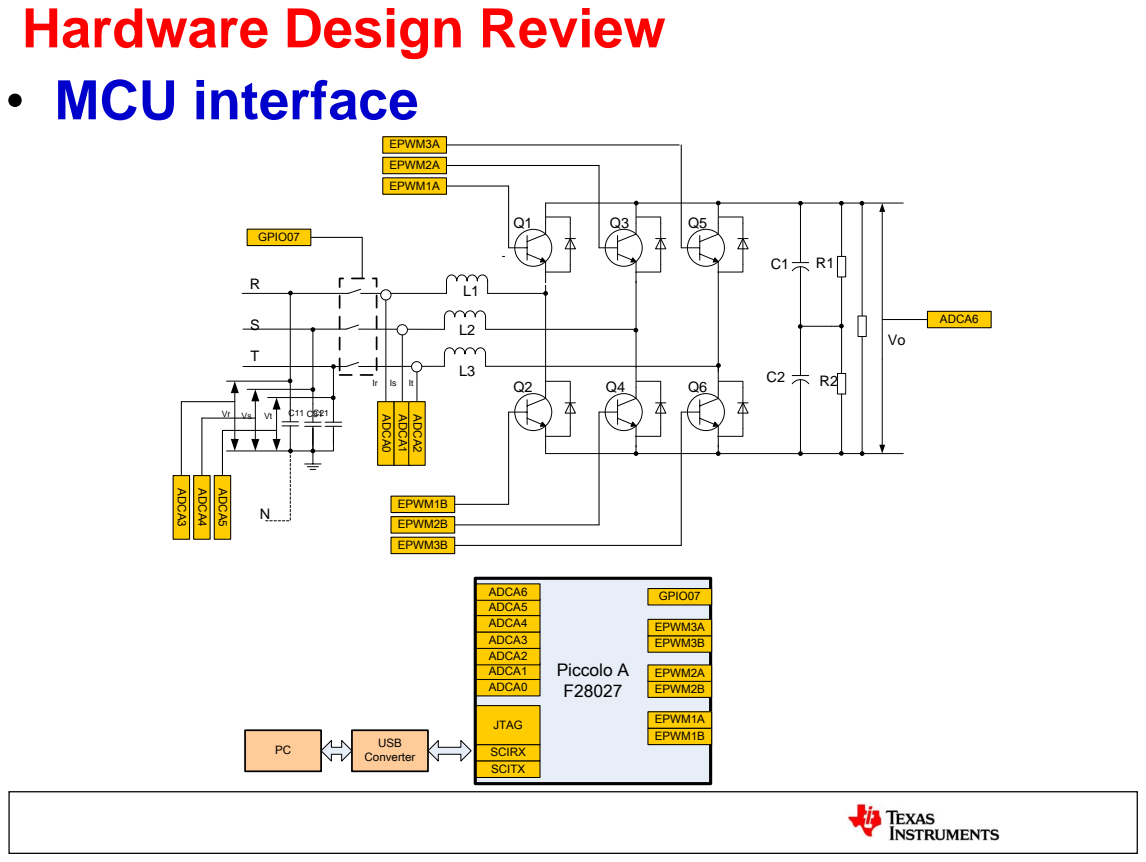
[picture p96: page 23]

JTAG USB Converter PC

# Content

## - Introduction

## - Hardware Design Review

## - Close-Loop Controller Review

# Software Design Review

# - Software Flow

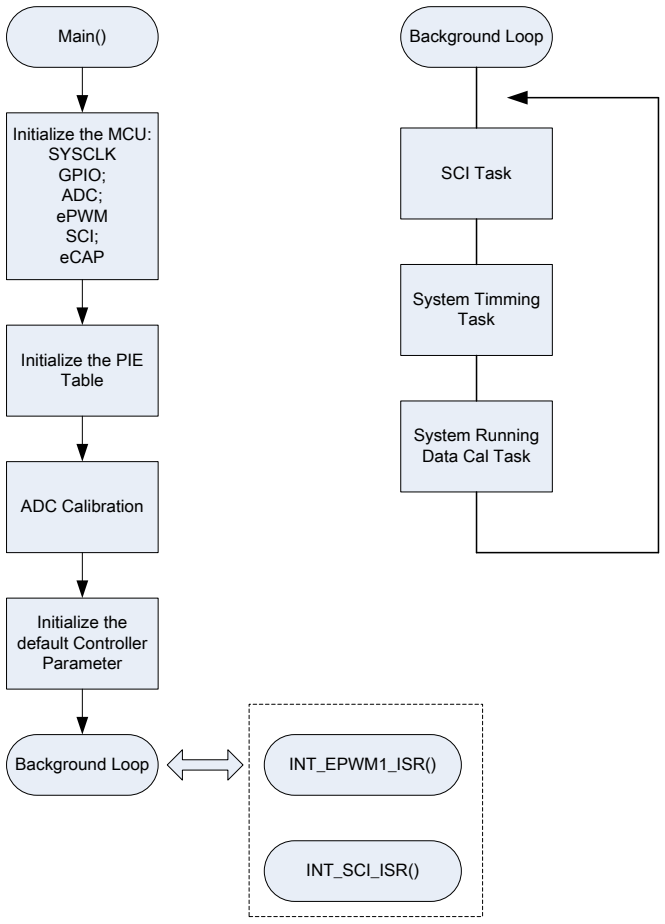
[picture p97: figure]
Main(); Initialize the PIE Table; Initialize the default Controller Parameter; ADC Calibration; Background Loop; INT_EPWM1_ISR(); SCI Task; System Timming Task; System Running Data Cal Task; INT_SCI_ISR()

Initialize the MCU: SYSCLK GPIO; ADC; ePWM SCI; eCAP

# Software Design

# •System Timing – Status machine

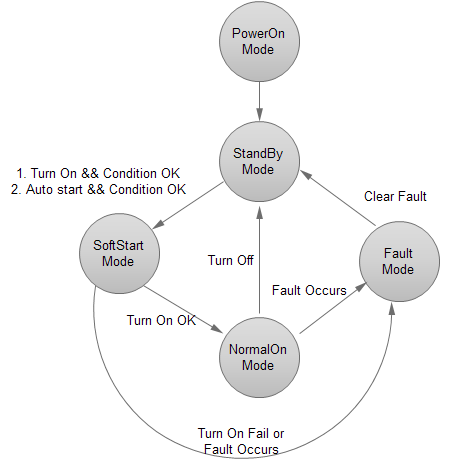
[picture p98: figure]

# Software Design Review

- Software Flow | INT_EPWM1_ISR() Read the ADC sample result Sample data processing

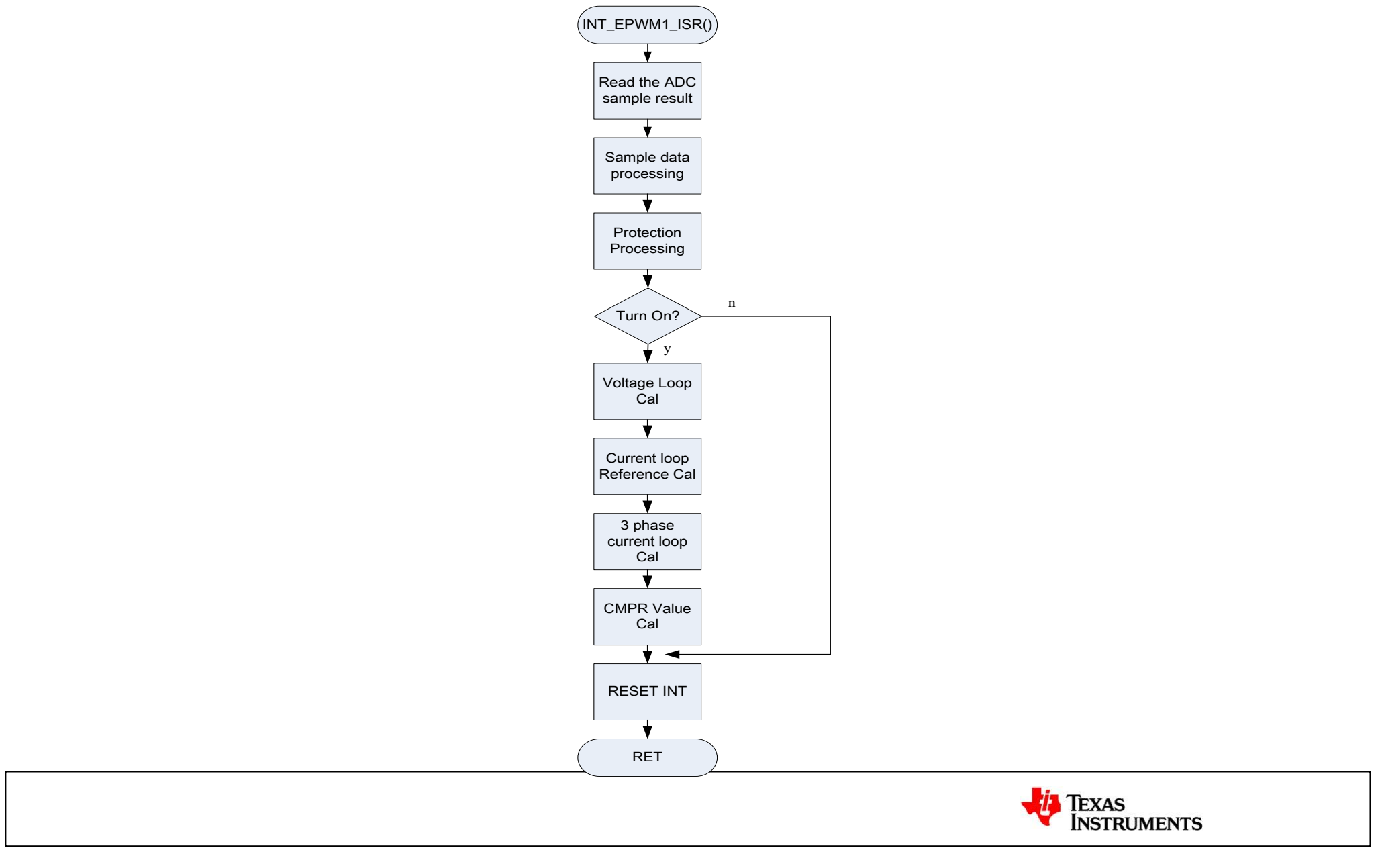
[picture p99: figure]
Voltage Loop Cal; Turn On?; CMPR Value Cal; Protection Processing; RET; RESET INT

Current loop Reference Cal 3 phase current loop Cal

# Software Design Review

# - ADC & ePWM

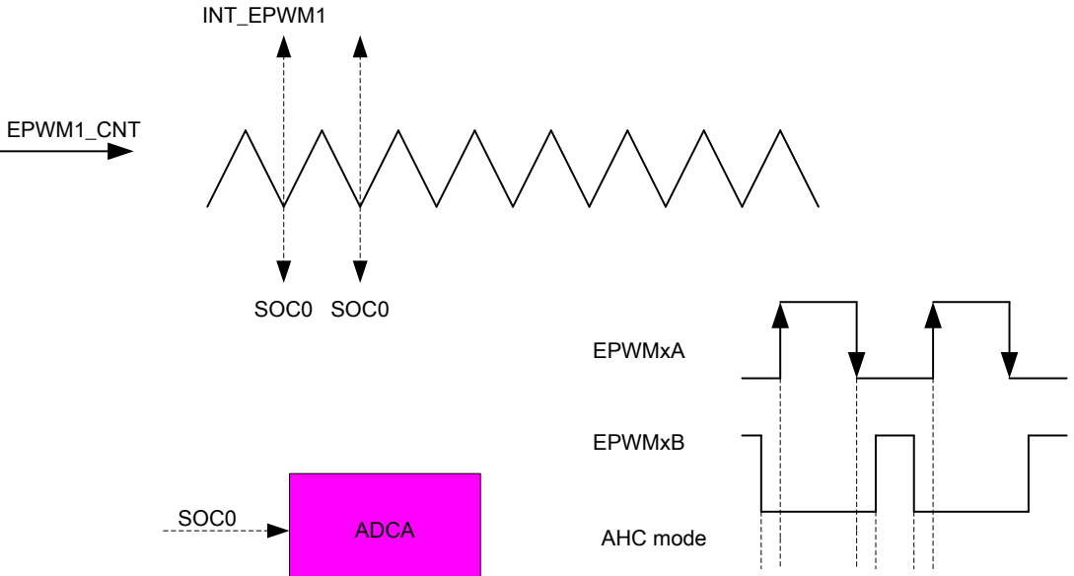
[picture p100: figure]
EPWM1_CNT; SOC0 SOC0; ADCA SOC0; INT_EPWM1; EPWMxA; EPWMxB; AHC mode
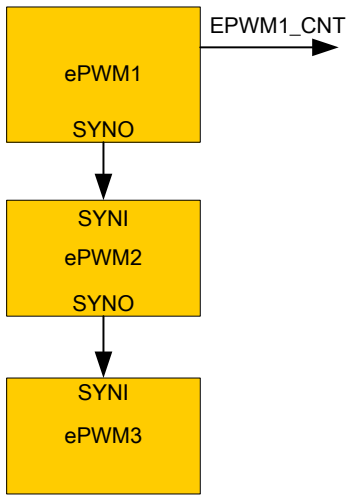
[picture p101: figure]
ePWM1; ePWM2; ePWM3; SYNO; SYNI

# Content

## - Introduction

## - Hardware Design Review

## - Software Design Review

# Close loop controller design

# - The Direct Current close loop diagram

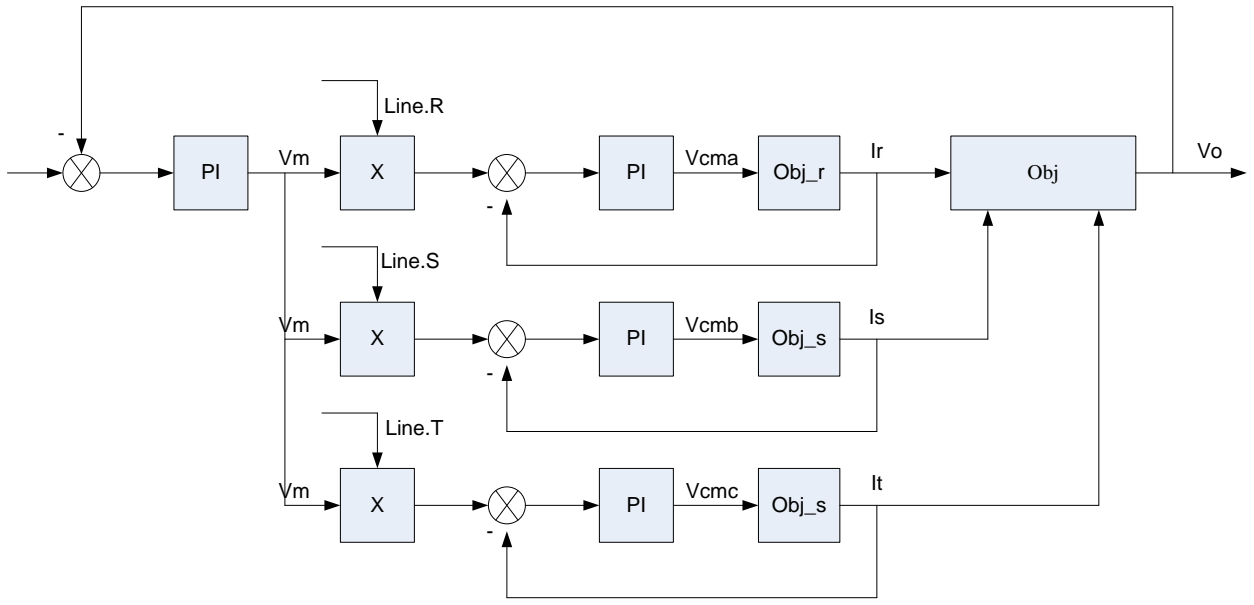
[picture p102: figure]
Line.R; Ir Vcma; Vo Obj_r - Vm; Is Vcmb; Obj_s - X Vm; Line.S; It Vcmc; Obj_s Line.T; Obj

# Close loop controller design

# - The current loop object analysis

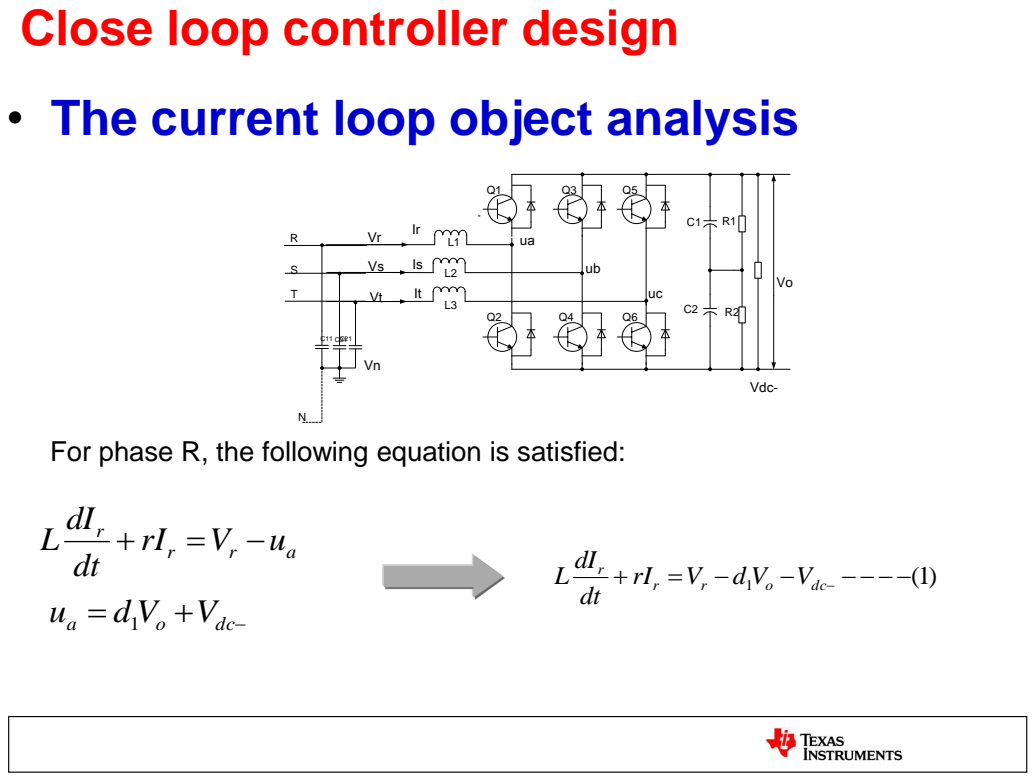
[picture p103: page 31]

# Close loop controller design

# - The current loop object analysis

(2) + s

=
s
- 2 o
- dc-

s
rI | V | d V V
dt

dI L

(3) + s

=
t
- 3 o
- dc-

t
rI V d V V
dt

dI L

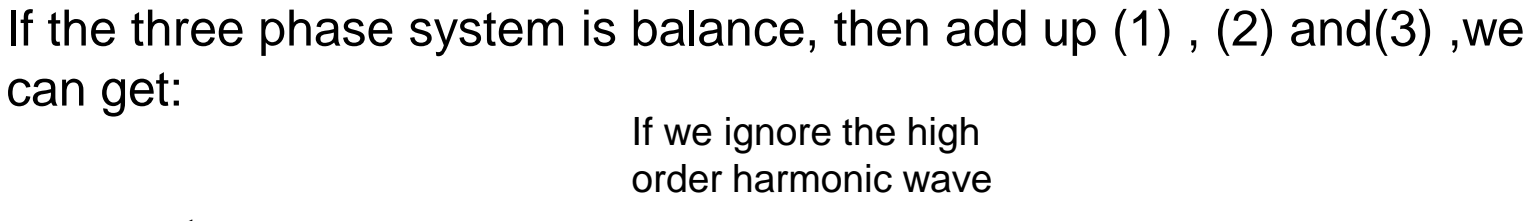
[picture p104: figure]
can get:; If we ignore the high order harmonic wave

If the three phase system is balance, then add up (1) , (2) and(3) ,we

Vdc | d | d | d Vdc ( | )
3

1

= - 1

+ 2

+ 3 | Vdc | Vdc 2

1

= -

# Close loop controller design

# - The current loop object analysis

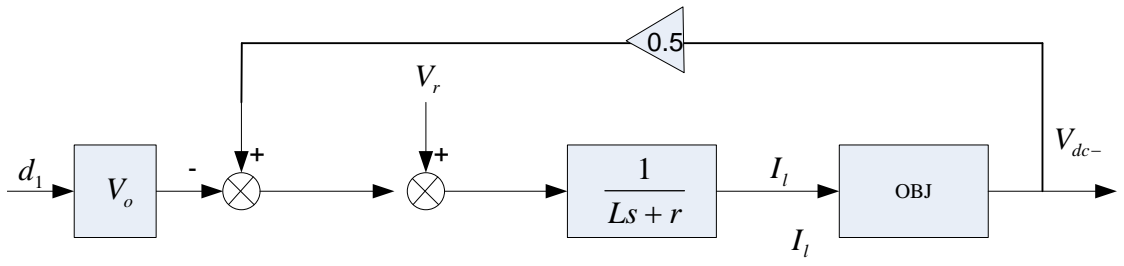
[picture p105: figure]
Vdc-; OBJ 0.-51

So, the current close-loop diagram is below

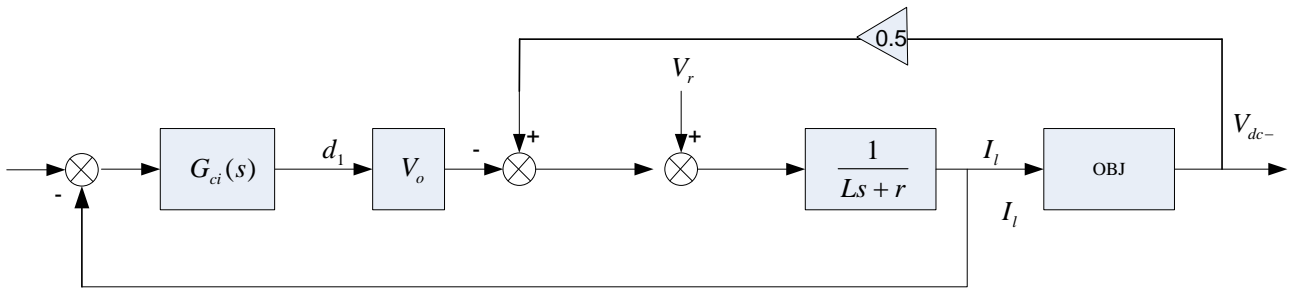
[picture p106: figure]
Vdc-; OBJ 0.-51

# Close loop controller design

# - The current loop object analysis

From the last diagram, we can see the Gs is enclosed by the current loop, so the open-loop transfer function is difficult to deal with. But we can use the feedback linearization to simplify the control loop.

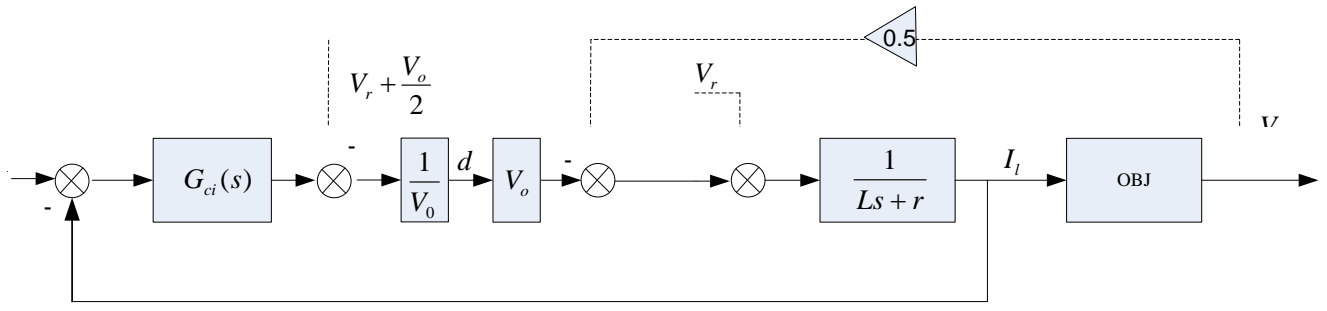
[picture p107: figure]
OBJ 0.-51; OBJ

# Close loop controller design

# - The current loop controller

From the analysis above, we can select the close loop controller and the plot the bode figure for the internal loop.

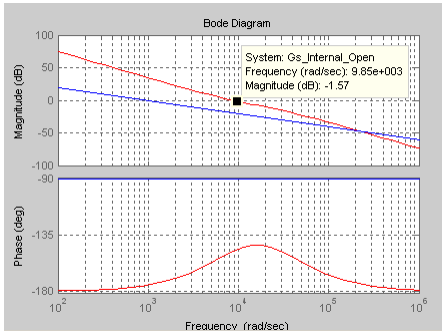
[picture p108: figure]

( | )
( | )
( )
s s b

K s a
G s ci
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
_ 0 | _1
1

( )
+ | +
+ | +
=
b z | b z
a | a z | a | z
G z
| c | c
c | c | c
ci

# Close loop controller design

# - The voltage loop controller

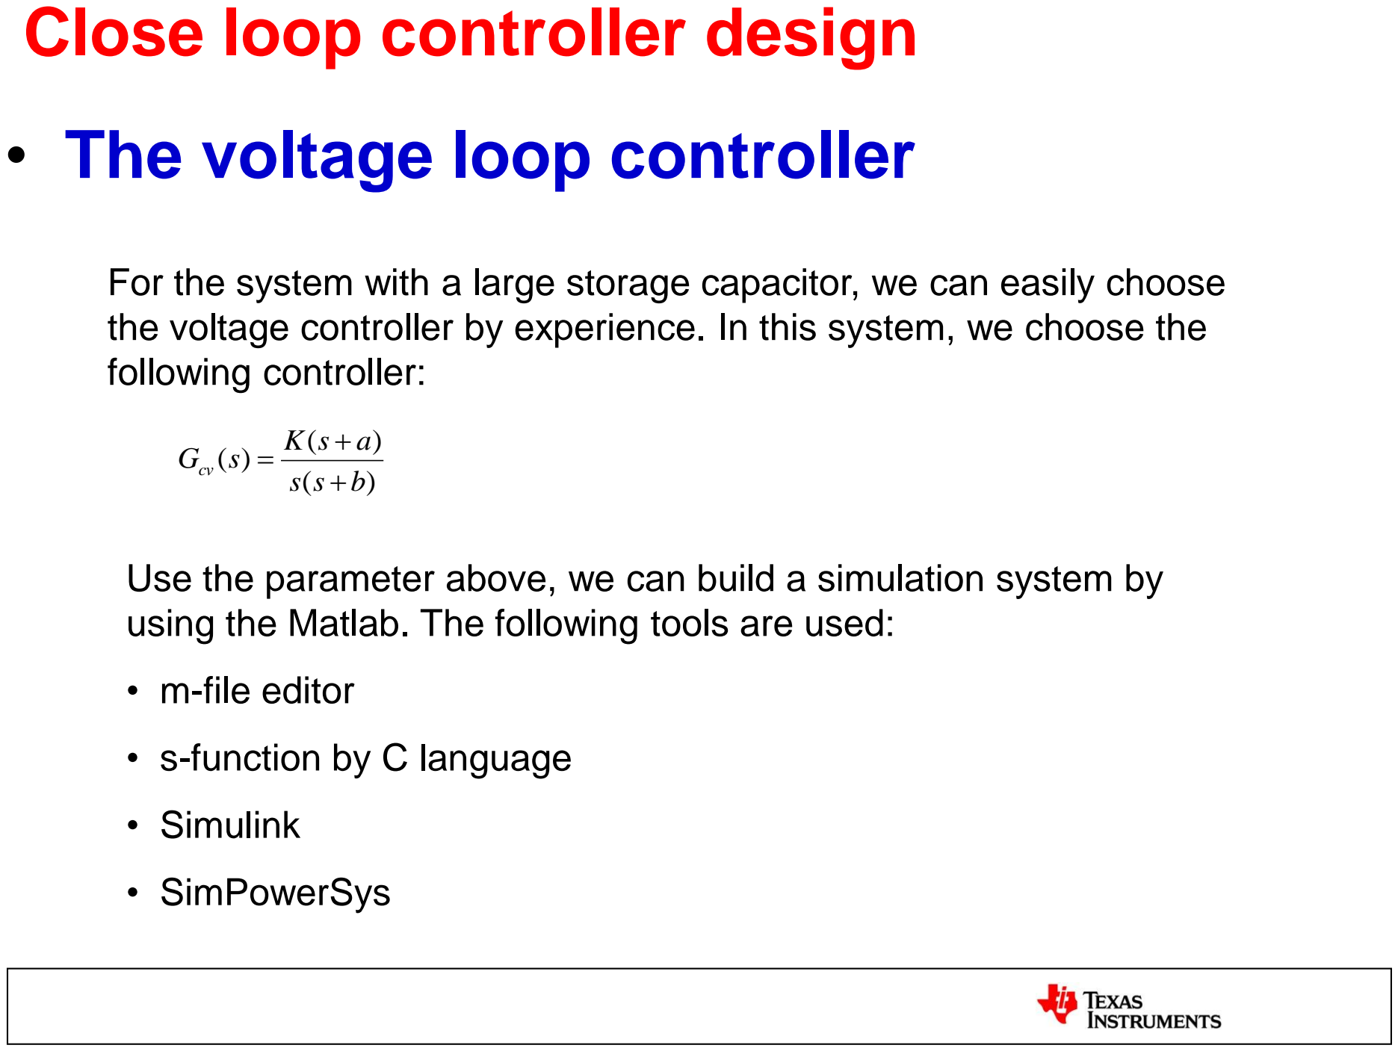
[picture p109: page 36]

For the system with a large storage capacitor, we can easily choose the voltage controller by experience. In this system, we choose the following controller:

( | )
( | )
( )
s s b

K s a
G s cv
+

+
=

Use the parameter above, we can build a simulation system by using the Matlab. The following tools are used:

- m-file editor
- s-function by C language
- Simulink
- SimPowerSys

# Close loop Controller Design

# - The simulation diagram

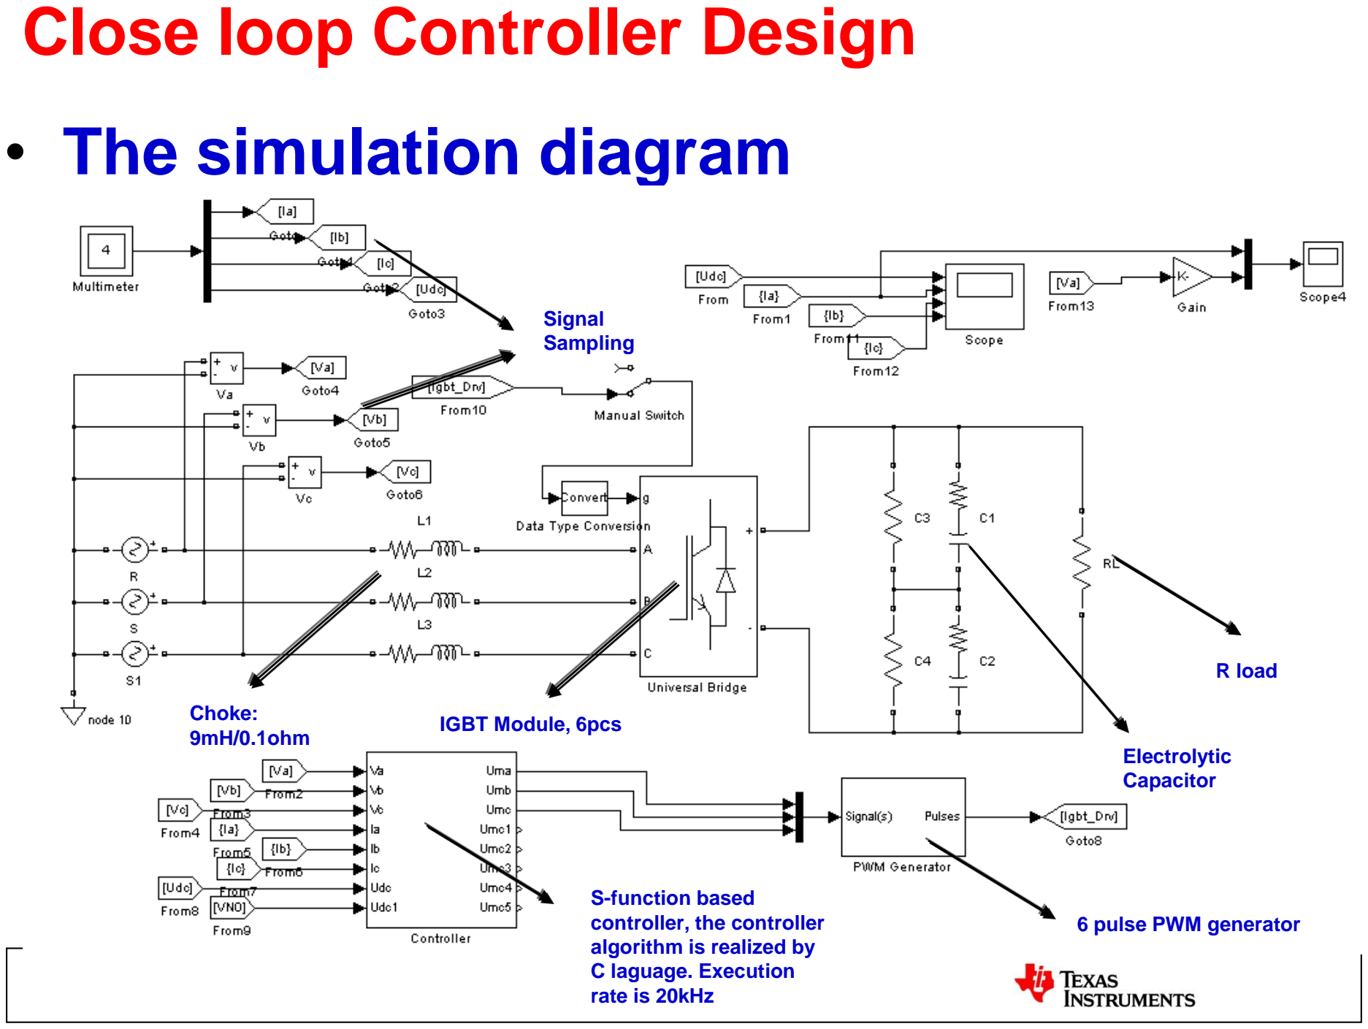
[picture p110: page 37]

S-function based
controller, the controller algorithm is realized by
C laguage. Execution
rate is 20kHz

R load

Signal
Sampling

IGBT Module, 6pcs

### 6 pulse PWM generator

Choke:
9mH/0.1ohm
Electrolytic
Capacitor

# Close loop Controller Design

# - The simulation result

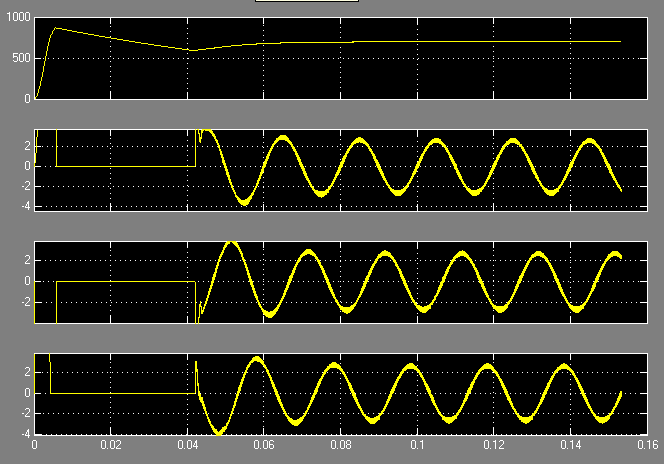
[picture p111: figure]

CH1: Vdc
CH2: R phase current
CH3: S phase current
CH4: T phase current

Conditions:
1. Directly input the
line voltage to the
converter from
0~0.04s;
2. At 0.04s, step to
700Vdc reference;
3. Full load.

# Close loop Controller Design

# - The simulation result --- Stable state

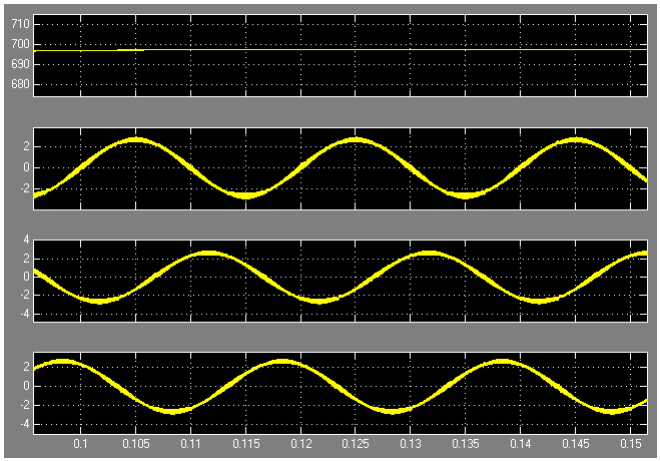
[picture p112: figure]

CH1: Vdc
CH2: R phase current
CH3: S phase current
CH4: T phase current

Conditions:

Full load at stable
state.

# Close loop Controller Design

# - The simulation result --- Stable state

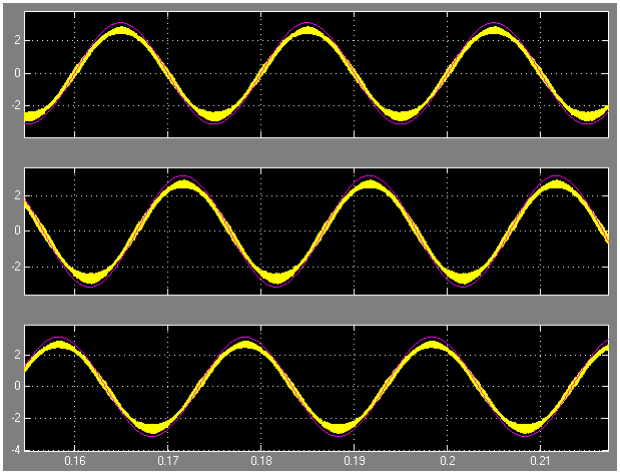
[picture p113: figure]

Yellow : phase current

Red: Line Voltage( 1/100)

# Close Loop Controller Design

# - The simulation result --- Stable state

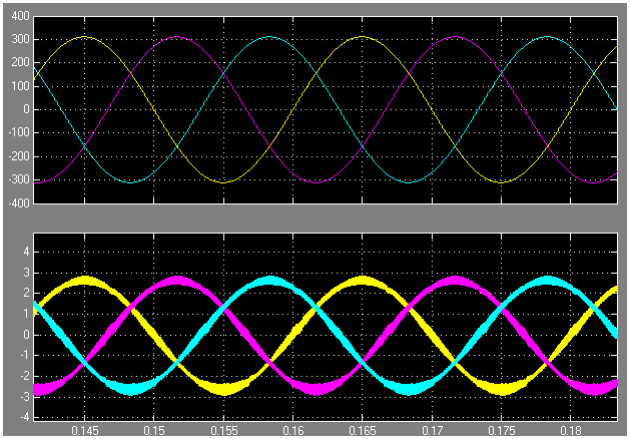
[picture p114: figure]

CH2 : phase current

CH1: Line Voltage( 1/100)

# Close Loop Controller Design

# - Runing Result – Bus Softstart

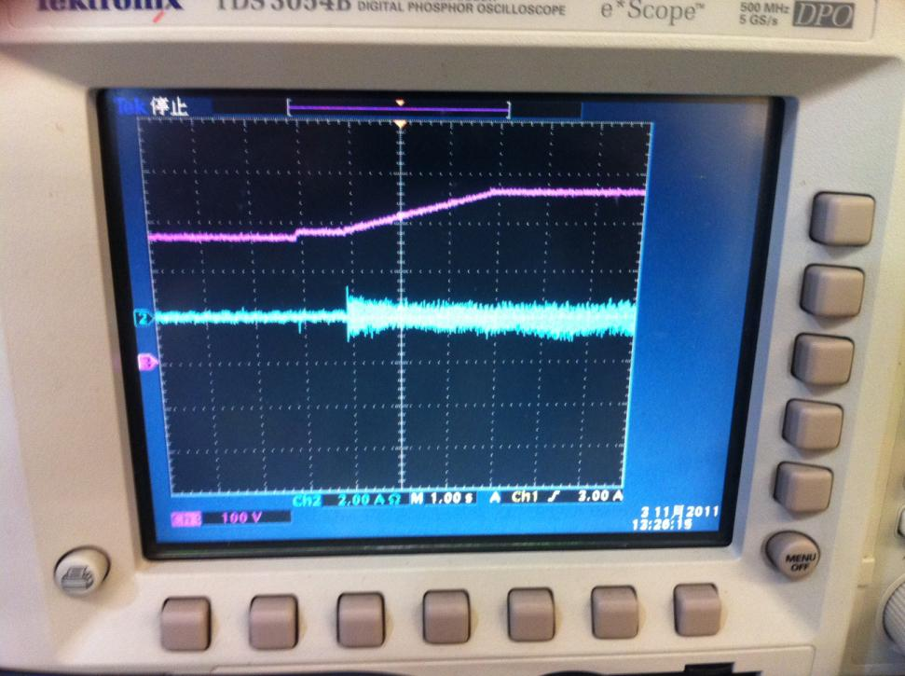
[picture p115: figure]

CH3 : Bus Voltage
(200V/div)

CH2: R Phase Input
Current

# Close Loop Controller Design

# - Runing Result – Current & Voltage

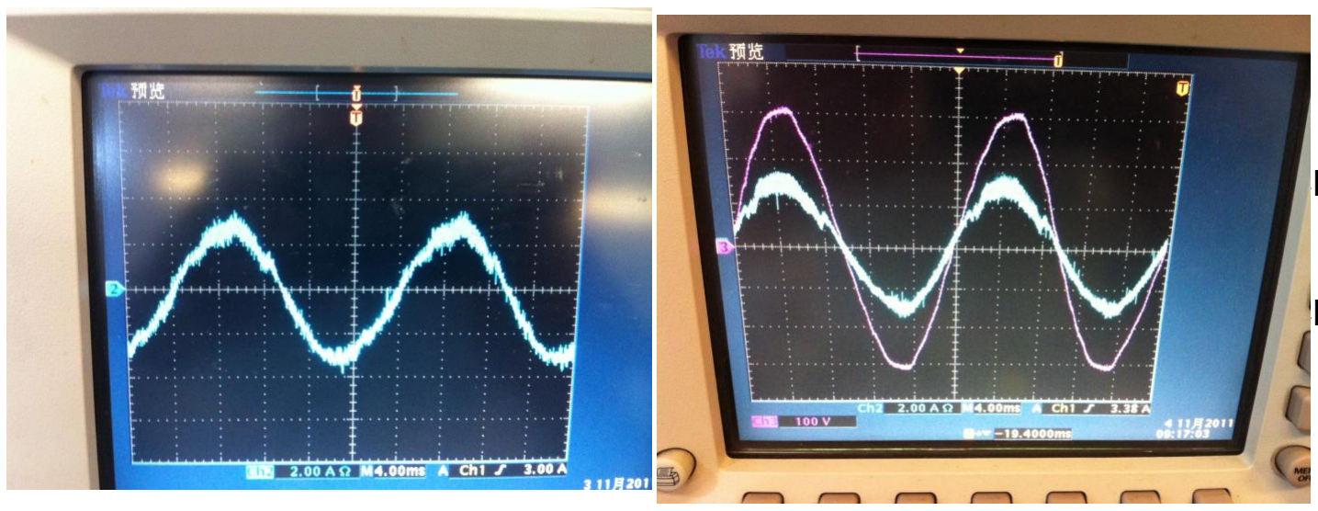
[picture p116: figure]

CH3 : Line Voltage
(200V/div)

CH2: R Phase Input
Current

# Close Loop Controller Design

# - Runing Result – The Optimized Current

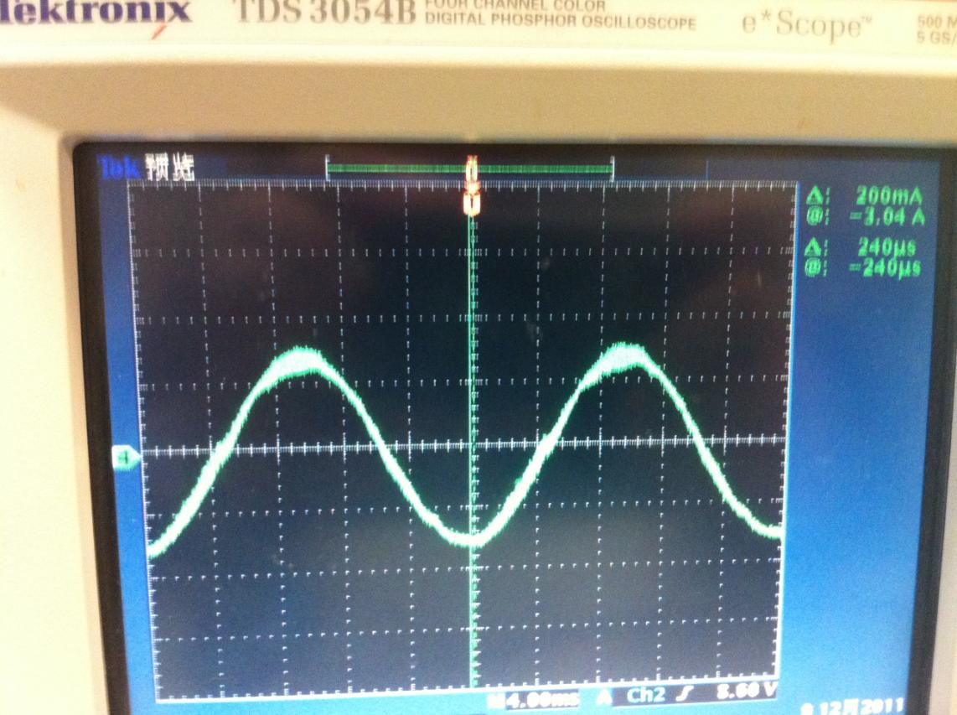
[picture p117: figure]

CH2: R Phase Input
Current

# Close Loop Controller Design

# - Runing Result – The THD & PF

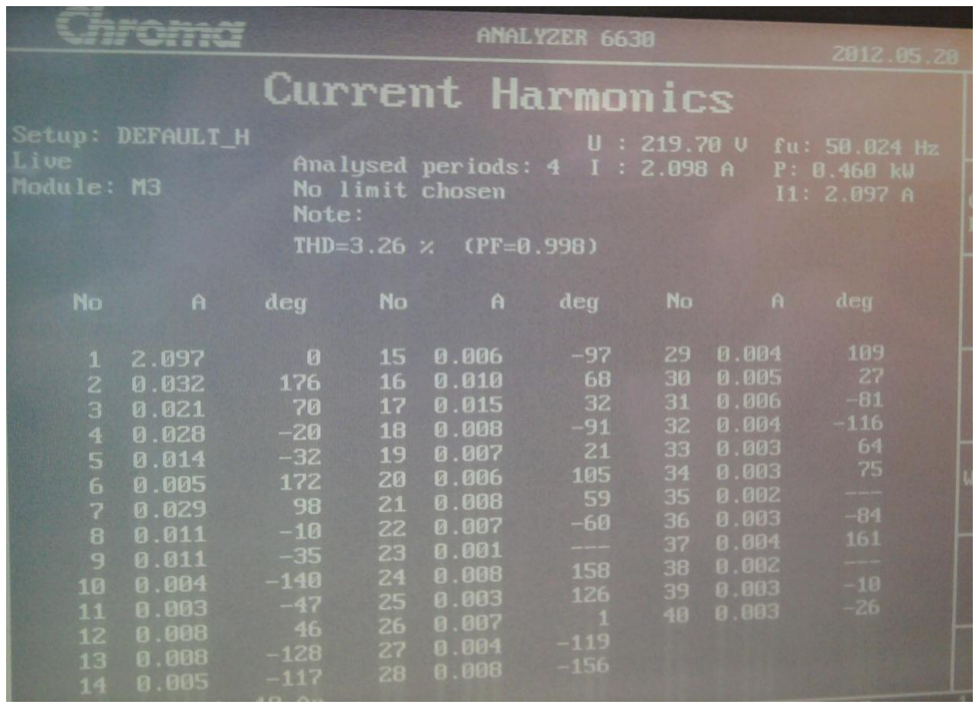
[picture p118: figure]

# Close Loop Controller Design

# - Runing Result – The Dynamic Response

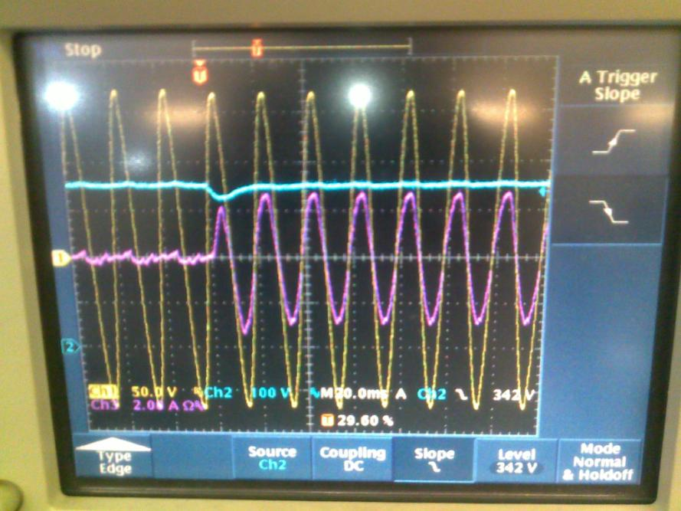
[picture p119: figure]

CH1 : Line Voltage
(100V/div)
CH2: Bus Voltage
CH3: Phase Current

# Close Loop Controller Design

# - Runing Result – The Dynamic Response

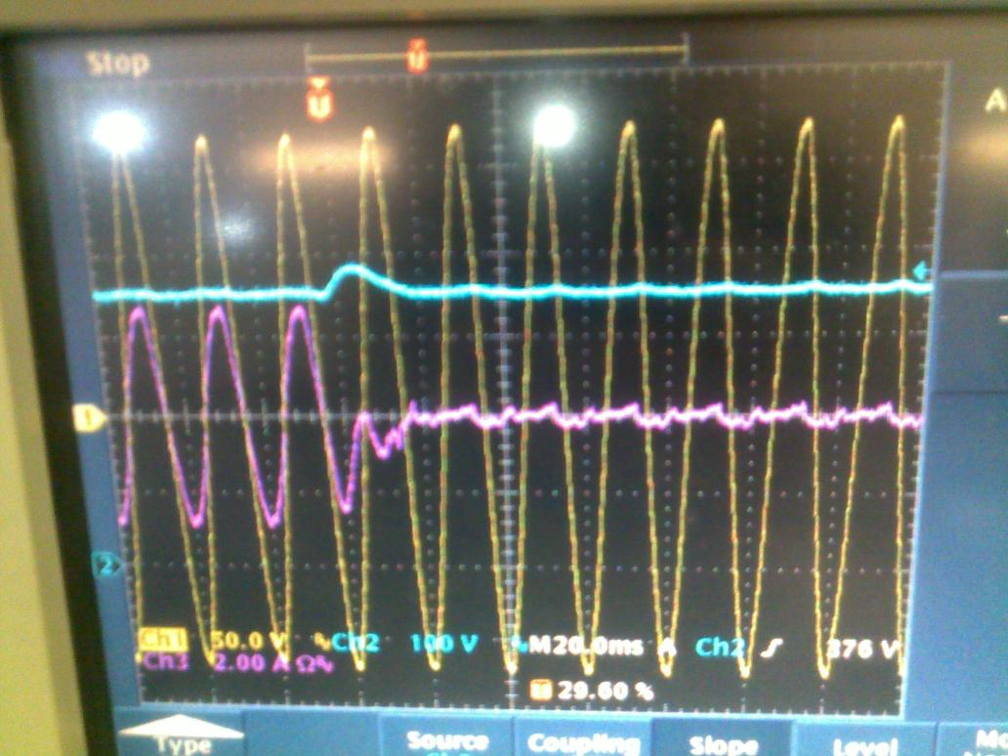
[picture p120: figure]

CH1 : Line Voltage
(100V/div)
CH2: Bus Voltage
CH3: Phase Current

Q&A

# Thanks!
