ozgurselenozge/EE463-Hardware-Project/Term Project/Simulation Report/Circuit topology with controller.png

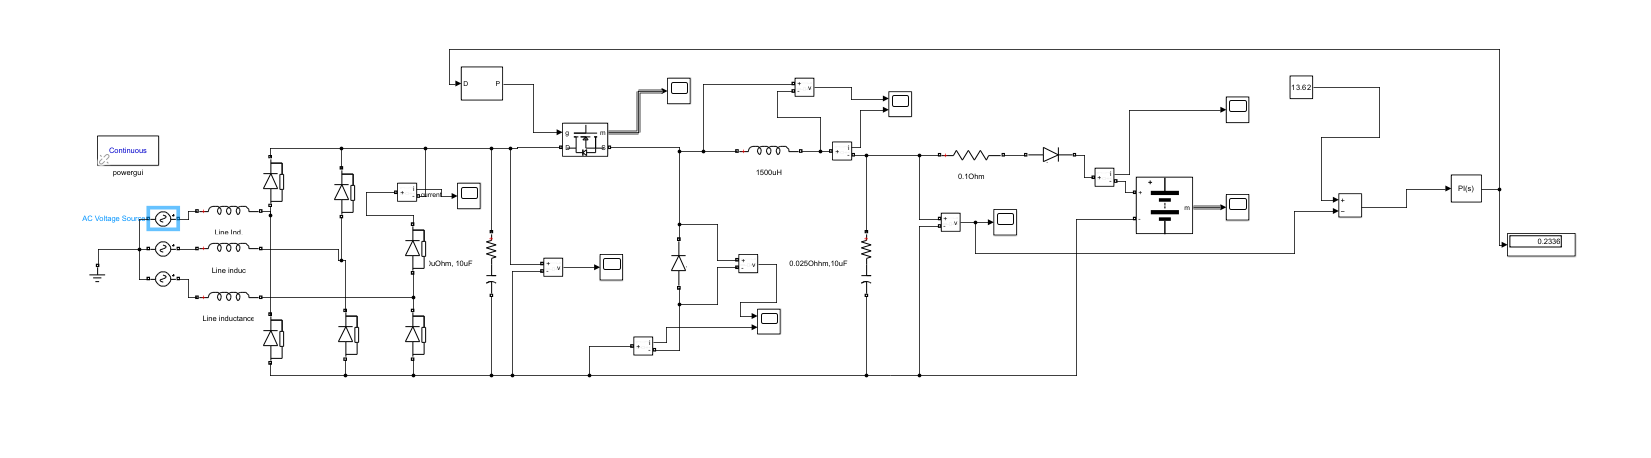
Term Project/Simulation Report/Circuit topology with controller.png
