ozgurselenozge/EE463-Hardware-Project/Term Project/Simulation Report/MOSFET Current.png

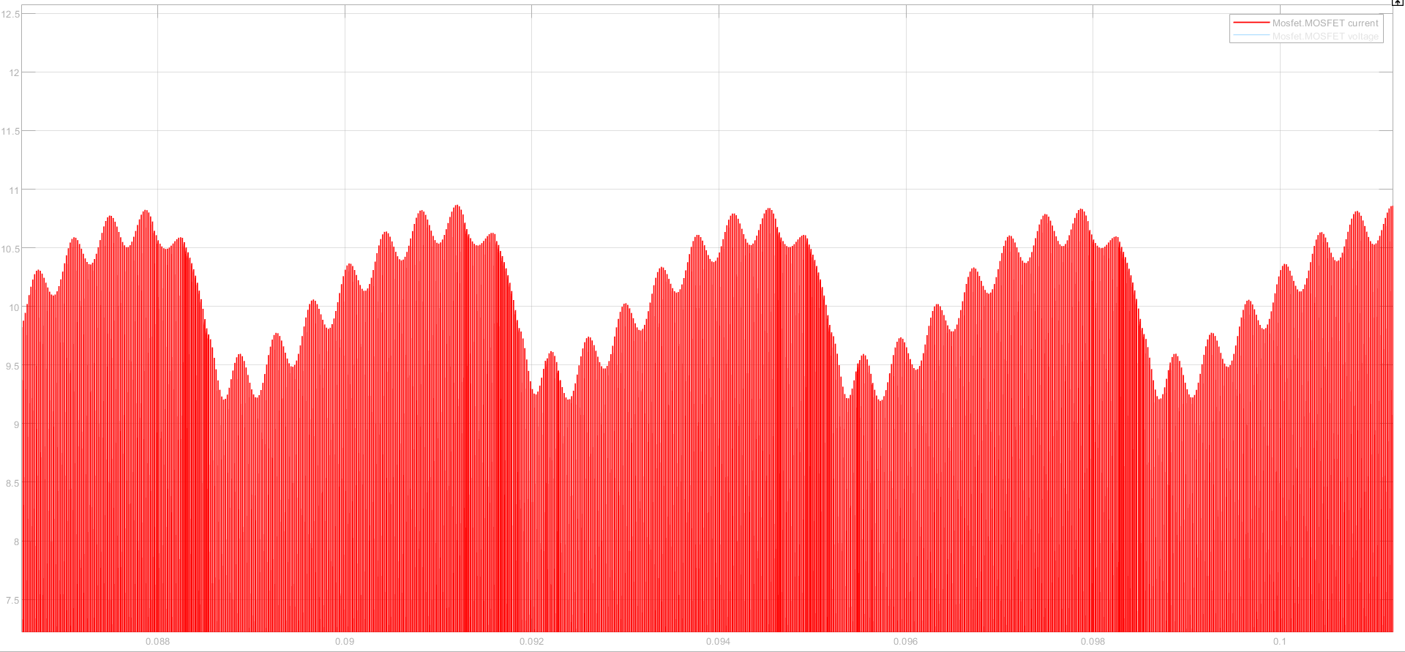
Term Project/Simulation Report/MOSFET Current.png
