ozgurselenozge/EE463-Hardware-Project/Term Project/Simulation Report/Topologies/3_p_diode_rect.jpeg

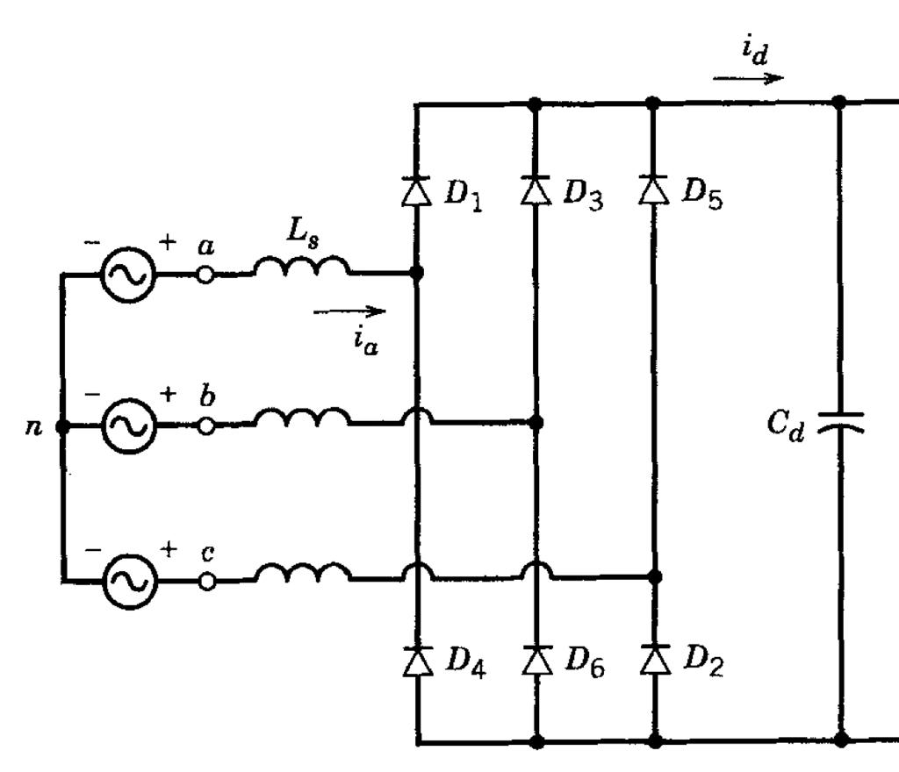
Term Project/Simulation Report/Topologies/3_p_diode_rect.jpeg
