ozgurselenozge/EE463-Hardware-Project/Term Project/Simulation Report/Topologies/3_p_thy_rect.jpeg

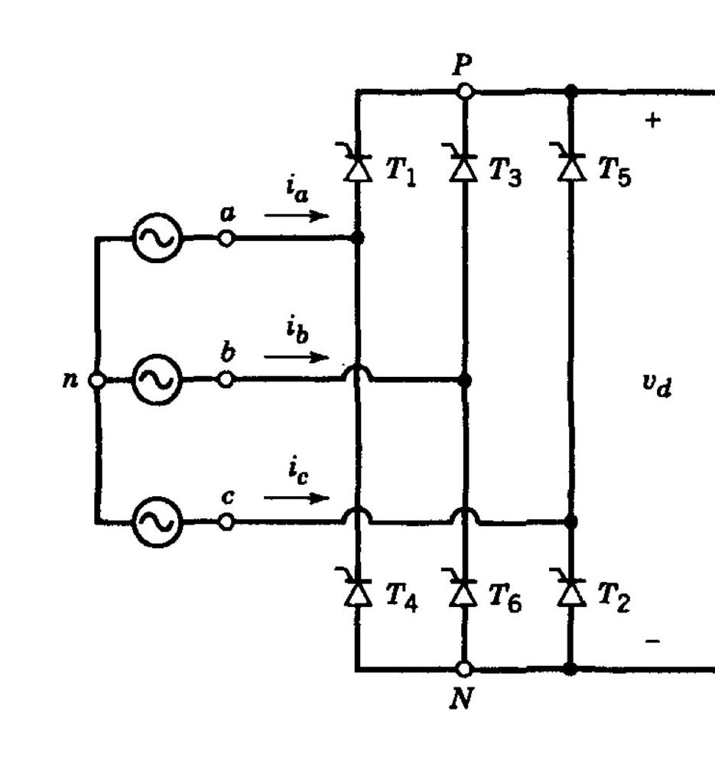
Term Project/Simulation Report/Topologies/3_p_thy_rect.jpeg
