ozgurselenozge/EE463-Hardware-Project/Term Project/Simulation Report/Topologies/three-phase_thyristor_rectifier_03.jpg

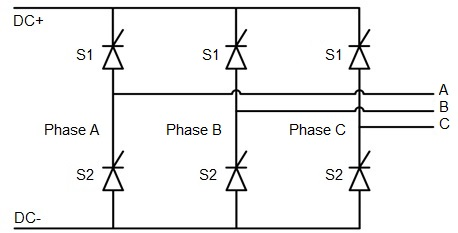
Term Project/Simulation Report/Topologies/three-phase_thyristor_rectifier_03.jpg
