ozgurselenozge/EE463-Hardware-Project/Term Project/Simulation Report/Topologies/Uncontrolled-six-diode-bridge-rectifier-and-buck-converter.png

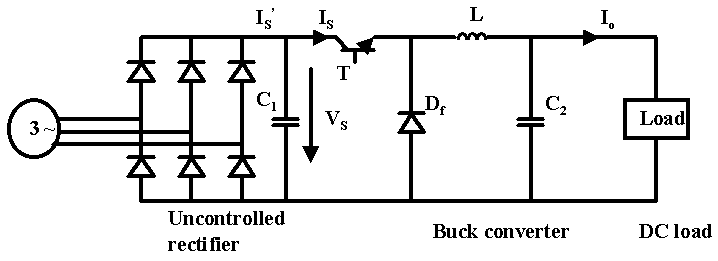
Term Project/Simulation Report/Topologies/Uncontrolled-six-diode-bridge-rectifier-and-buck-converter.png
