ozgurselenozge/EE463-Hardware-Project/Term Project/Simulation Report/Component List.docx

# Component List

3 Phase Rectifier

Diode Rectifier:

Modül Diyotlar (direnc.net) (https://www.direnc.net/modul-diyotlar-1383)

Gereksiz pahalılar anlamadım

Capacitor

Buck Converter

Inductor

SRI1204: 220uH 12X12 1.3A - SMD Güç Bobini - SRI1204 Uygun Fiyatıyla Satın Al - Direnc.net® (https://www.direnc.net/220uh-12x12-13a-smd-guc-bobini-sri1204) (ben bunu seçerdim)

SR!1209: 220uH 12X12 2.2A - SMD Güç Bobini - SRI1209 Uygun Fiyatıyla Satın Al - Direnc.net® (https://www.direnc.net/220uh-12x12-22a-smd-guc-bobini-sri1209)

MOSFET

IRF9Z24NPBF: IRF9Z24NPBF P Kanal Mosfet TO-220 - 55V 12A Uygun Fiyatıyla Satın Al - Direnc.net® (https://www.direnc.net/irf9z24npbf-p-kanal-mosfet-to-220-55v-12a)

IRD540 N: IRF540 N Kanal Power Mosfet TO-220 Uygun Fiyatıyla Satın Al - Direnc.net® (https://www.direnc.net/irf540-n-channel-power-mosfets-27-a-60-100v)

Capacitor

Diode
