ozgurselenozge/EE463-Hardware-Project/Term Project/Simulation Report/needed_ratings_for_25V_line_to_line_operation.xlsx

Component | Yeri | Max V | Steady-State V | Max I | Steady-State I
capacitor | rectifier | 35V | 33V | ? | ?
diode | rectifier | 35V | 35V | 12A
mosfet | buck | 35V |  | 10A | 11.5A
diode | buck | 35V |  | 12A | 10.5A
inductor | buck | 32V |  | 50A
capacitor | buck | 14V | 13.75V |  | 5mA
diode | batarya öncesi |  |  | 11.5 | 10.2
