ozgurselenozge/EE463-Hardware-Project/Term Project/Simulation Report/Calculations.pdf

Typ!cally between 0.

### Vatmax=12V

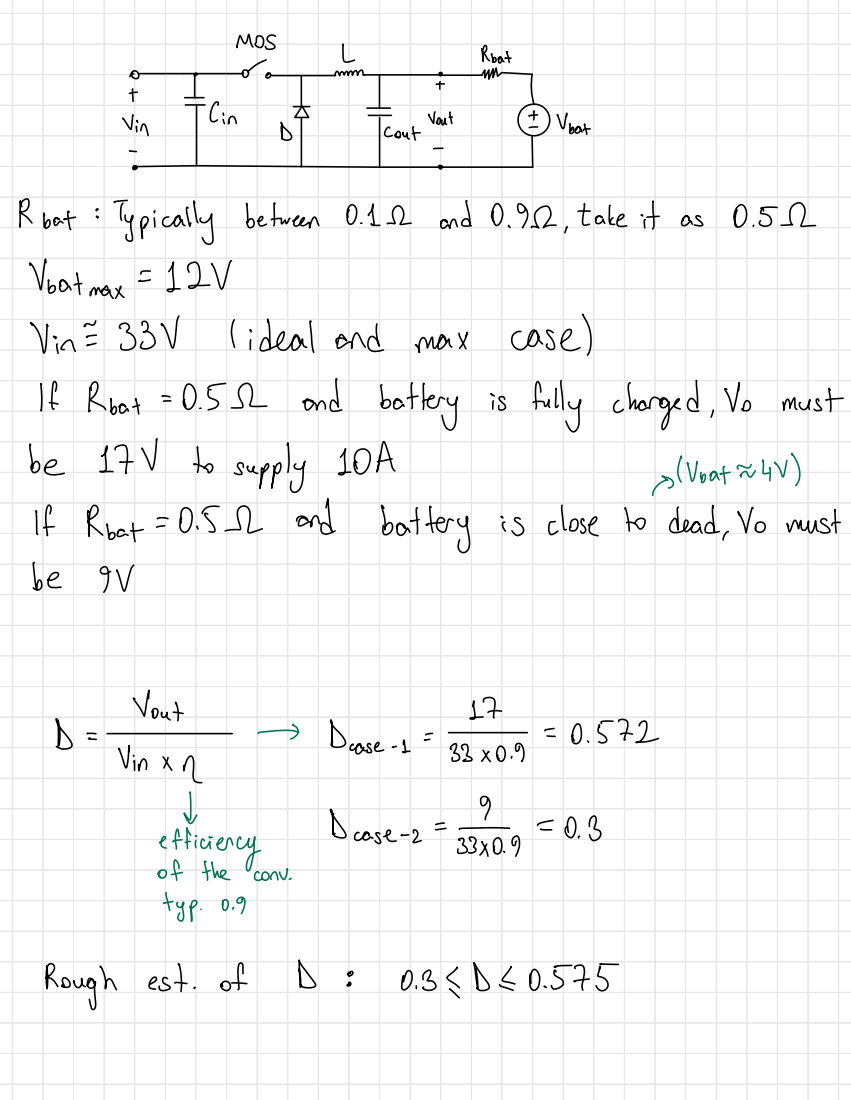
[picture p139: page 1]
MOS; Rbet :; end; take !t as; l!deal; max; case); If Rbet=0.; battery; fully; charged .; must; be 17V to supply; elVat4V); If Root =0.5ch; and; close; dead,; Vout; V!nxy; eff!c!ency; D case-z =; typ.; Rough est .

L | | | Rbat
um

D | | Cout | Vout | | I Vat

-> | Dase-2 | = | | = | 0 . | 572

of the CONV.

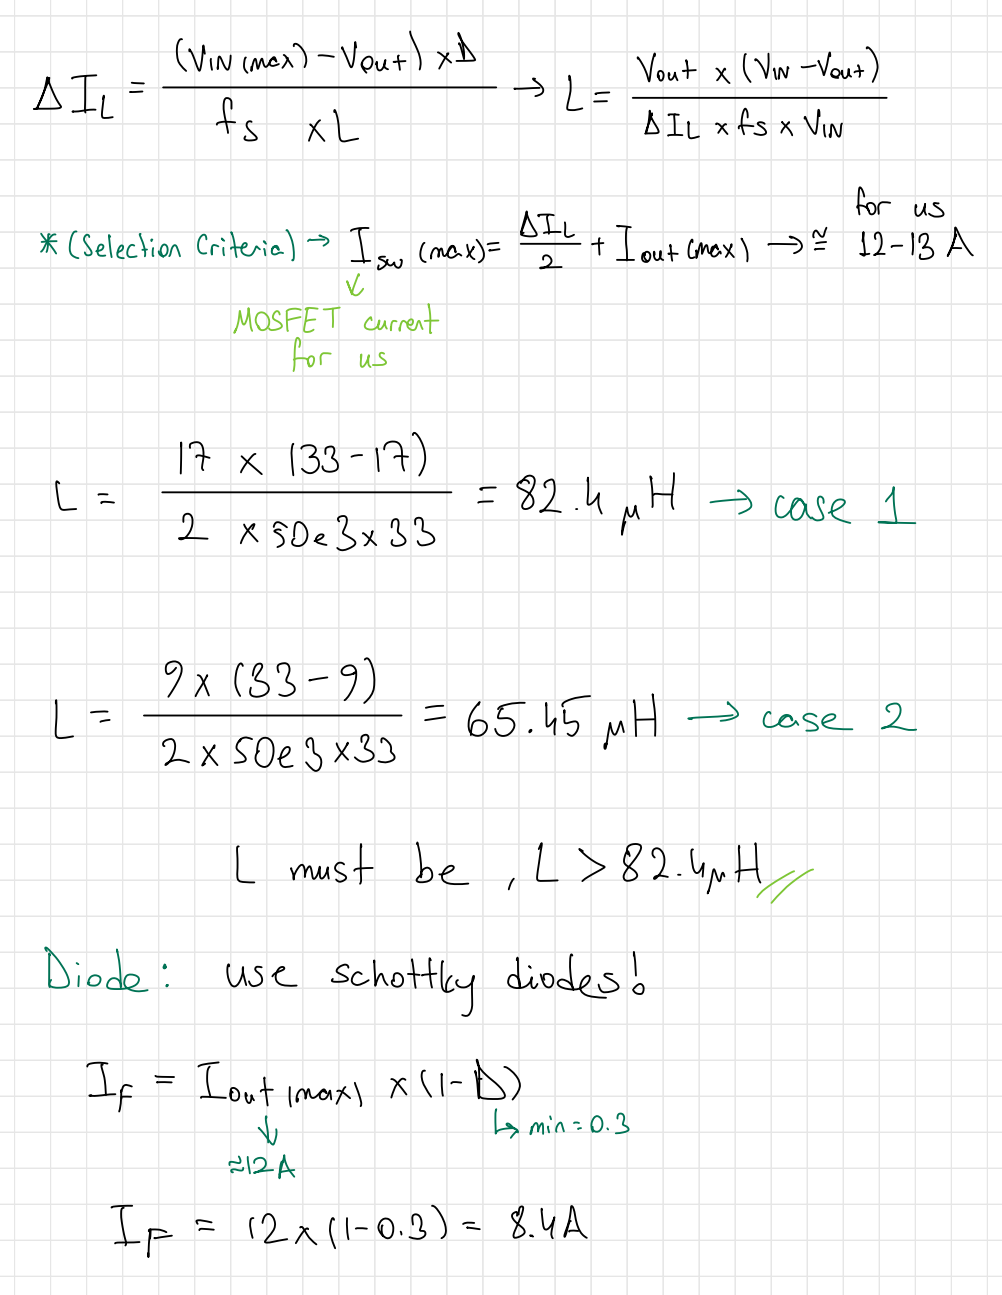
[picture p140: page 2]

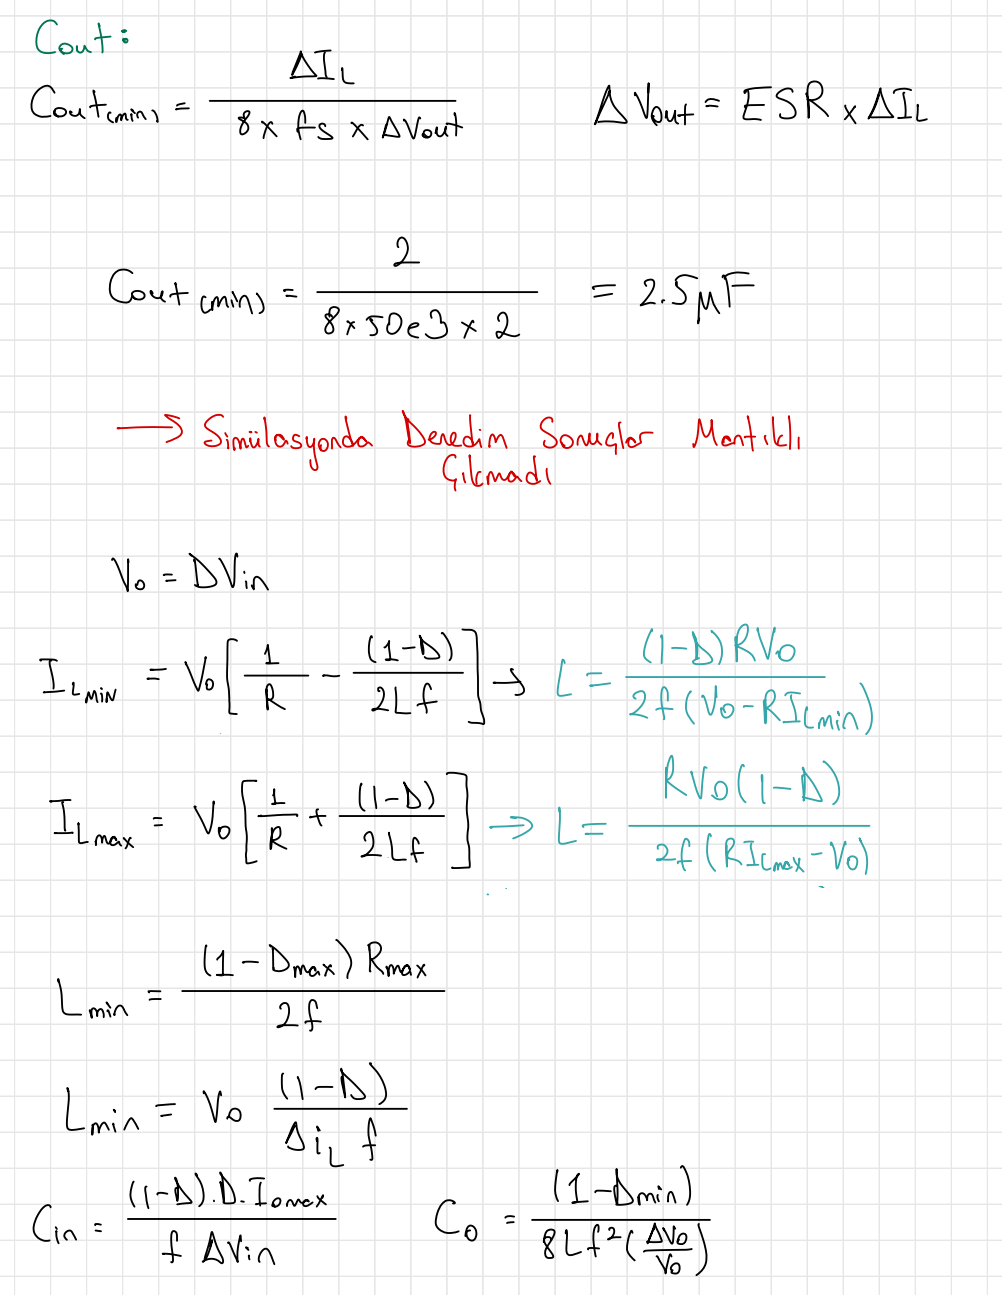
[picture p141: page 3]

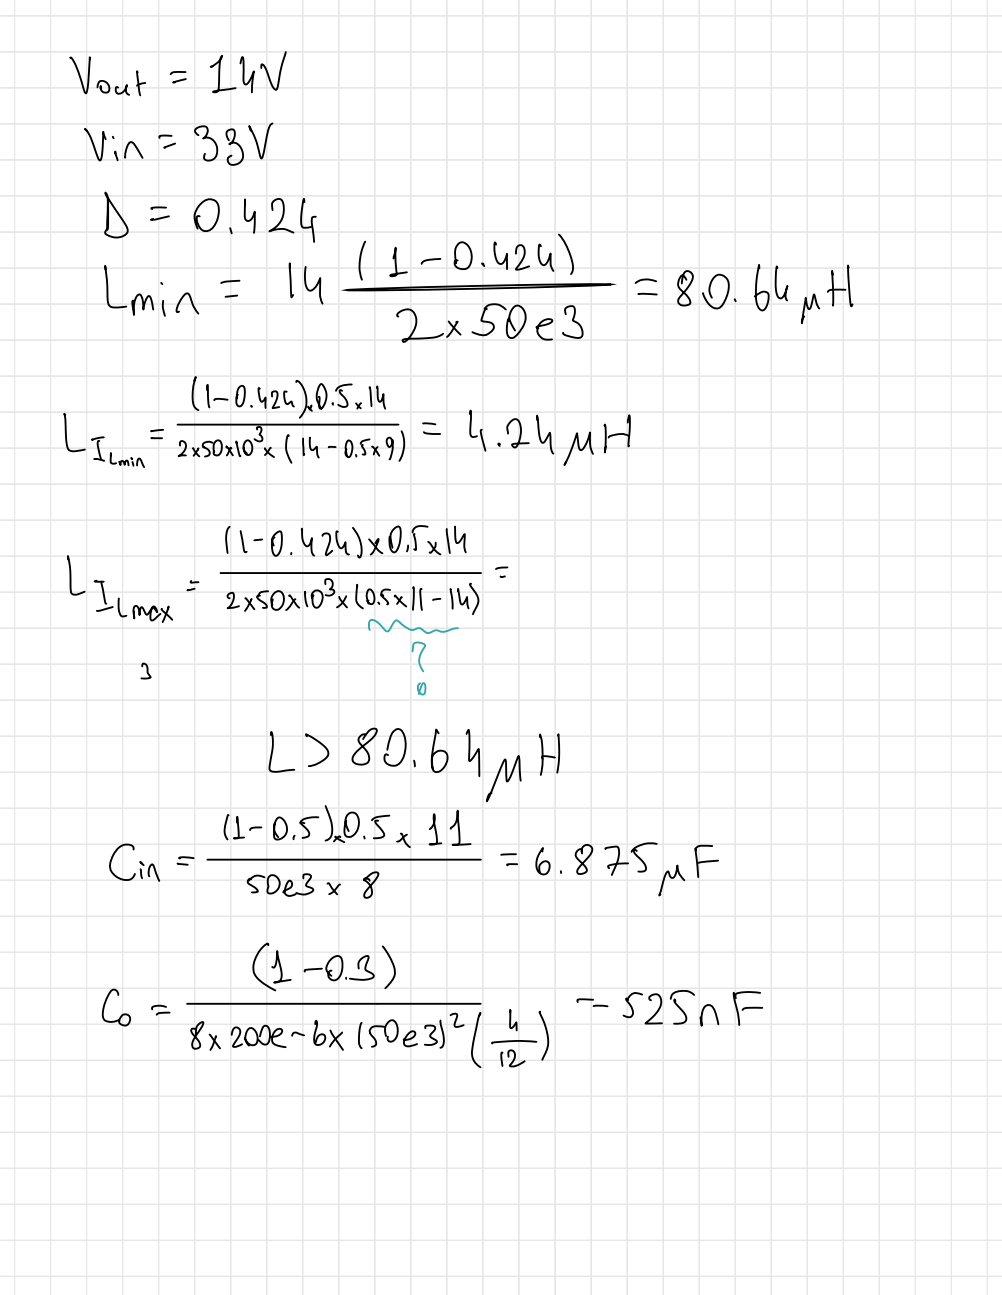
[picture p142: page 4]
