ozgurselenozge/EE463-Hardware-Project/Term Project/Simulation Report/term-project simulation.asc

C1: polcap; 470µ; V=63 Irms=2.225 Rser=0.0272 Lser=8.842n mfg="Würth Elektronik" pn="860080778023 WCAP-ATLI 13x30" type="Al electrolytic"
C2: polcap; 470µ; V=50 Irms=1.8 Rser=0.045 Lser=7n mfg="Würth Elektronik" pn="860040675011 WCAP-ATUL 10x30" type="Al electrolytic"
D1: diode; RF2001NS2D
D2: diode; RF2001NS2D
D3: diode; RF2001NS2D
D4: diode; RF2001NS2D
D5: diode; RF2001NS2D
D6: diode; RF2001NS2D
D7: schottky; RB085BM-60
L1: ind; 560µ; Ipk=7 Rser=0.0774 Rpar=52752 Cpar=0 mfg="Coilcraft" pn="PCV-2-564-08"
L2: ind; 560µ; Ipk=7 Rser=0.0774 Rpar=52752 Cpar=0 mfg="Coilcraft" pn="PCV-2-564-08"
L3: ind; 560µ; Ipk=7 Rser=0.0774 Rpar=52752 Cpar=0 mfg="Coilcraft" pn="PCV-2-564-08"
L4: ind; 150µ; Ipk=9.2 Rser=0.0306 Rpar=35180 Cpar=13.607p mfg="Würth Elektronik" pn="74437529203151 WE-HCF 2920"
M1: nmos; IRF530
R1: res; 2
V1: voltage; SINE(0 20.41 50 0 0 0)
V2: voltage; SINE(0 20.41 50 0 0 120)
V3: voltage; SINE(0 20.41 50 0 0 -120)
V4: voltage; PULSE(0 5 0 1n 1n 10u 20u)
Named nets: 0
.tran 0.08
