ozgurselenozge/EE463-Hardware-Project/(commit log)

2023-11-22 Modified Buck Converter init
    [needed_ratings_for_25V_line_to_line_operation.xlsx]
2023-11-25 Initial "normal" buck converter
    Initial normal buck converter simulation
2023-11-26 Measurements added and inductor val. change
    I added measrement ports for MOSFET and diode rectifiers capacitor. Inductor value chanaged.
2023-11-26 Component List with MOSFET and inductor options
    2 MOSFET and 2 inductor suggestion
2023-11-26 Analytical Calculation, finding inductor and R
    I found possible inductor value and resistor value analytically
2023-11-26 Peak capacitor current (rectifier side) solved
    10 ohm series resistor connected to capacitor
2023-11-27 50A 60V 0.022ohm Rdson MOSFET
2023-11-27 17A 55V 0.07ohm Rdson MOSFET (₺14.08)
2023-11-27 48A 60V 0.023ohm Rdson MOSFET (₺12.23)
2023-12-01 design the buck converter
2023-12-01 buck converter with DC source at the output
2023-12-01 Analytical Cal. from Taufik presentat.
    Previous analytical calculation is totally wrong because the output current is not equal to 10 A. These calculations are not valid also because in Simulink, the system response is not as expected. Anyway, I am still uploading these calculations here.
2023-12-02 Create input capacitor links
    Input capacitor links for the capacitors that we could not find the datasheet for.
2023-12-02 Update input capacitor links
    second link added, the second capacitor will be parallel to the electrolyd capacitor to decrease the ESR.
2023-12-02 Create output capacitor links
    Link for the output capacitor, we used tantal since it has decreased ESR.
2023-12-02 Diode to be used before the battery
    Diode to be used before the battery, it can be found in direncnet.
2023-12-02 Converter Diode
    Diode to be used in the converter, it can be found in direncnet.
2023-12-02 Create Rectifier Link
    Rectifier linki, powerlab componentlarında var, birden fazla kullanılacak.
2023-12-02 Planned MOSFET, probably final
    We plan to used this.
2023-12-03 PWM rectifier
    3 phase 3 level PWM rectifier guide
2023-12-03 output voltage sense
2023-12-05 MOSFET current waveform with the controller
2023-12-05 final circuit topology
2023-12-06 Update capacitor links
2023-12-06 Create Drivers
2023-12-06 Update Drivers
2023-12-06 input capacitor and buck inductor updated
2023-12-14 Create Heat sink
2023-12-14 Update Heat sink
    Heat sink for rectifier
